controlprogram/mk312-bt/bluetooth_conf/HC05PINOUT.png

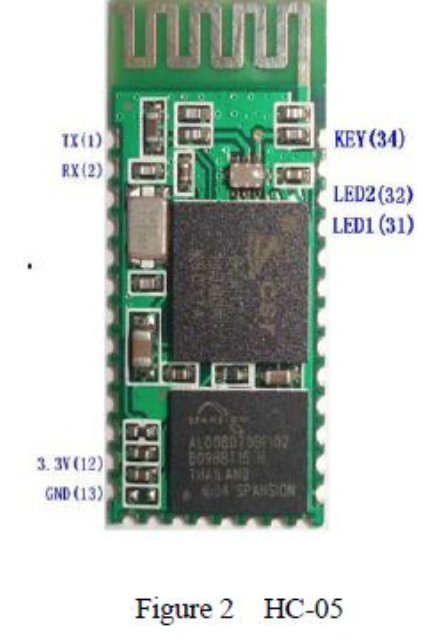
bluetooth_conf/HC05PINOUT.png
