controlprogram/mk312-bt/images/V1.2/6.JPG

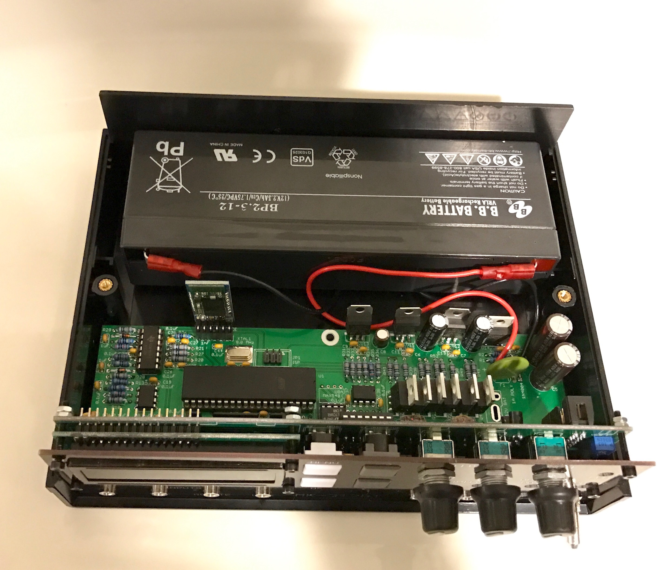
images/V1.2/6.JPG
