controlprogram/mk312-bt/README.md

MK-312BT V1.2

Documentation at : http://tinyurl.com/mk312bt-info
