controlprogram/mk312-bt/images/V1.2/1.JPG

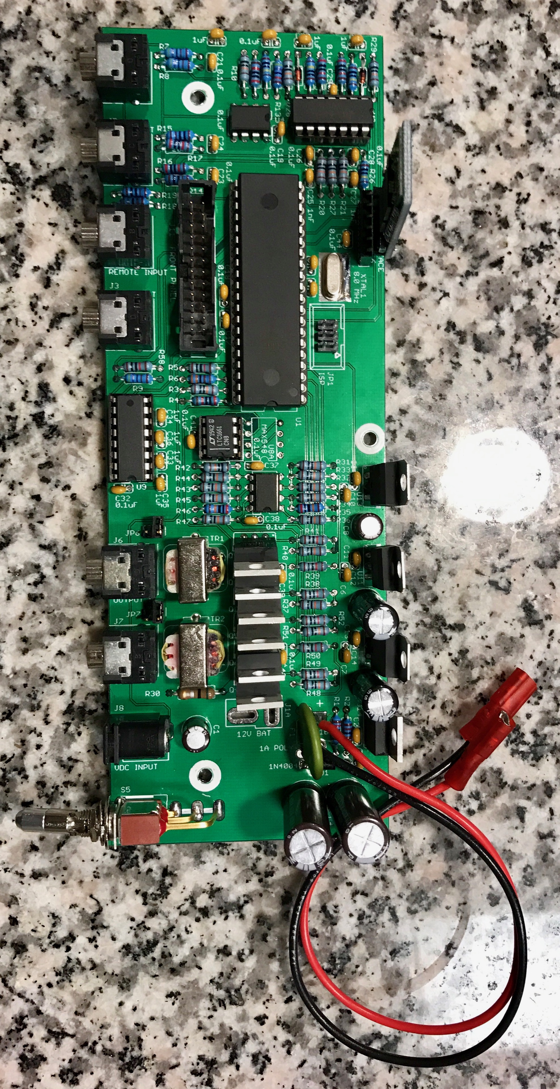
images/V1.2/1.JPG
