controlprogram/mk312-bt/images/V1.2/2.JPG

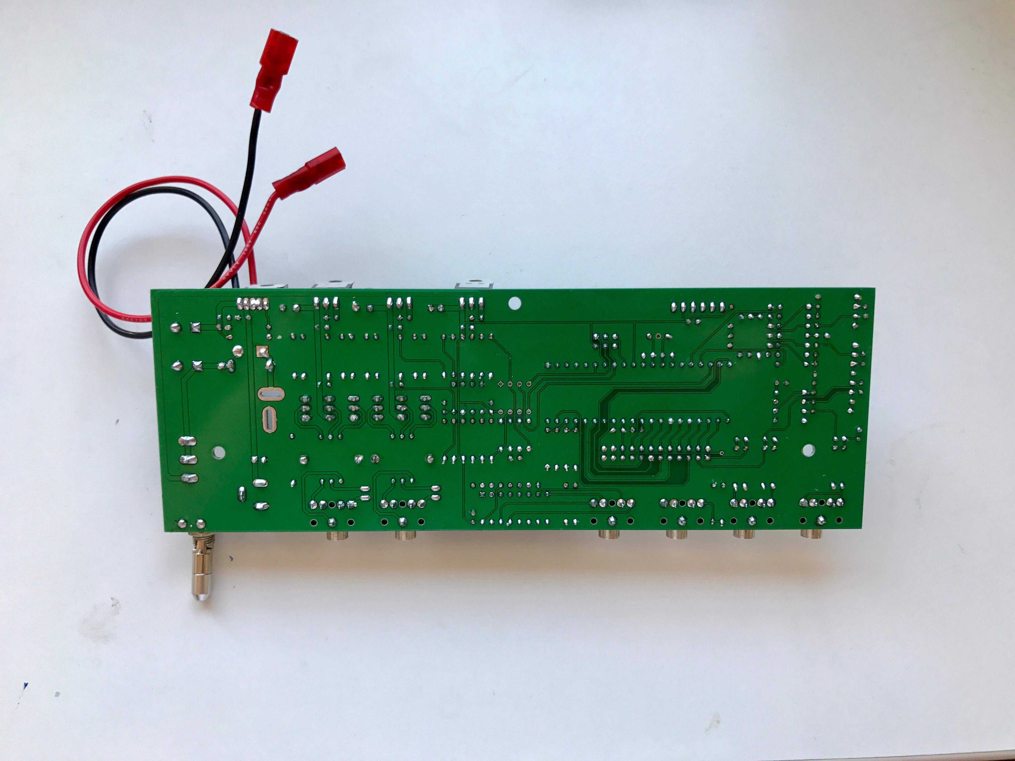
images/V1.2/2.JPG
