controlprogram/mk312-bt/images/V1.2/3.JPG

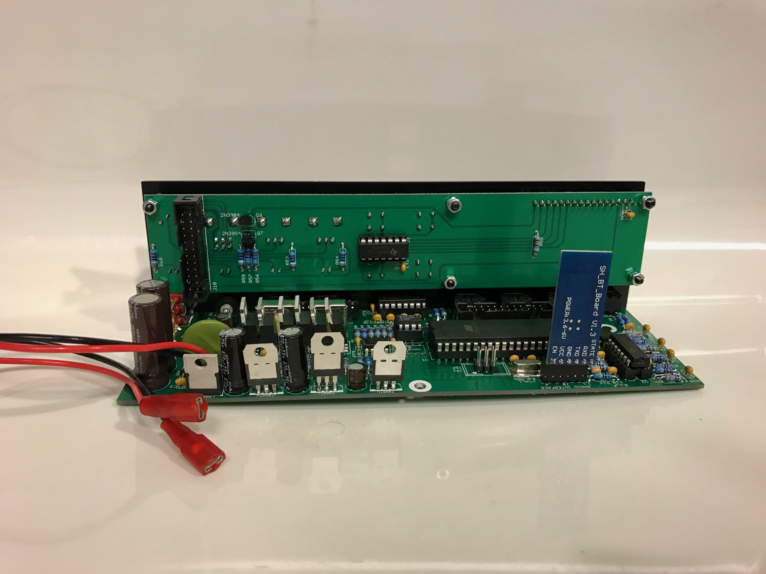
images/V1.2/3.JPG
