controlprogram/mk312-bt/images/V1.2/4.JPG

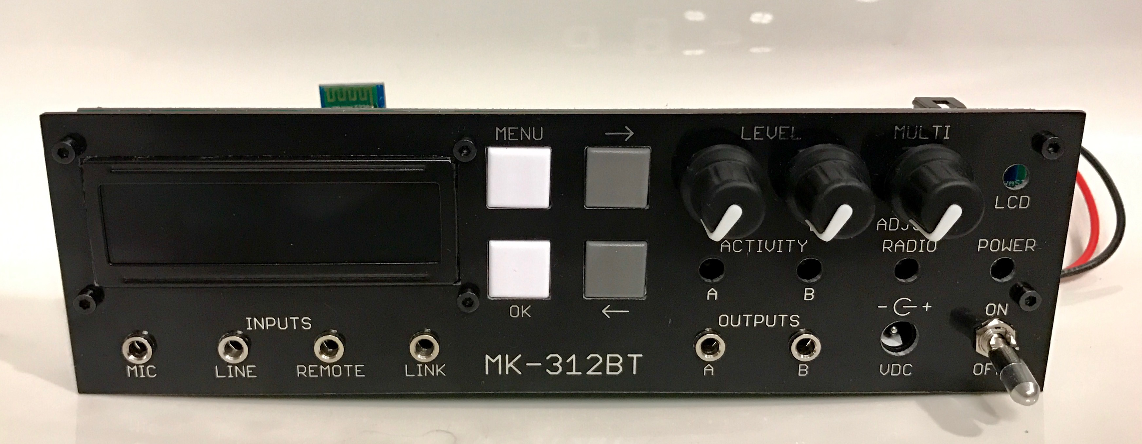
images/V1.2/4.JPG
