controlprogram/mk312-bt/images/V1.2/5.JPG

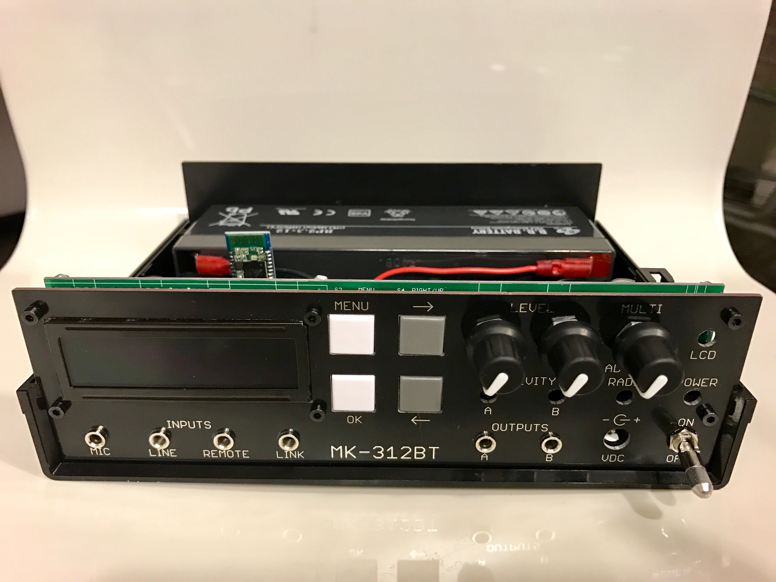
images/V1.2/5.JPG
