controlprogram/mk312-bt/images/V1.2/7.JPG

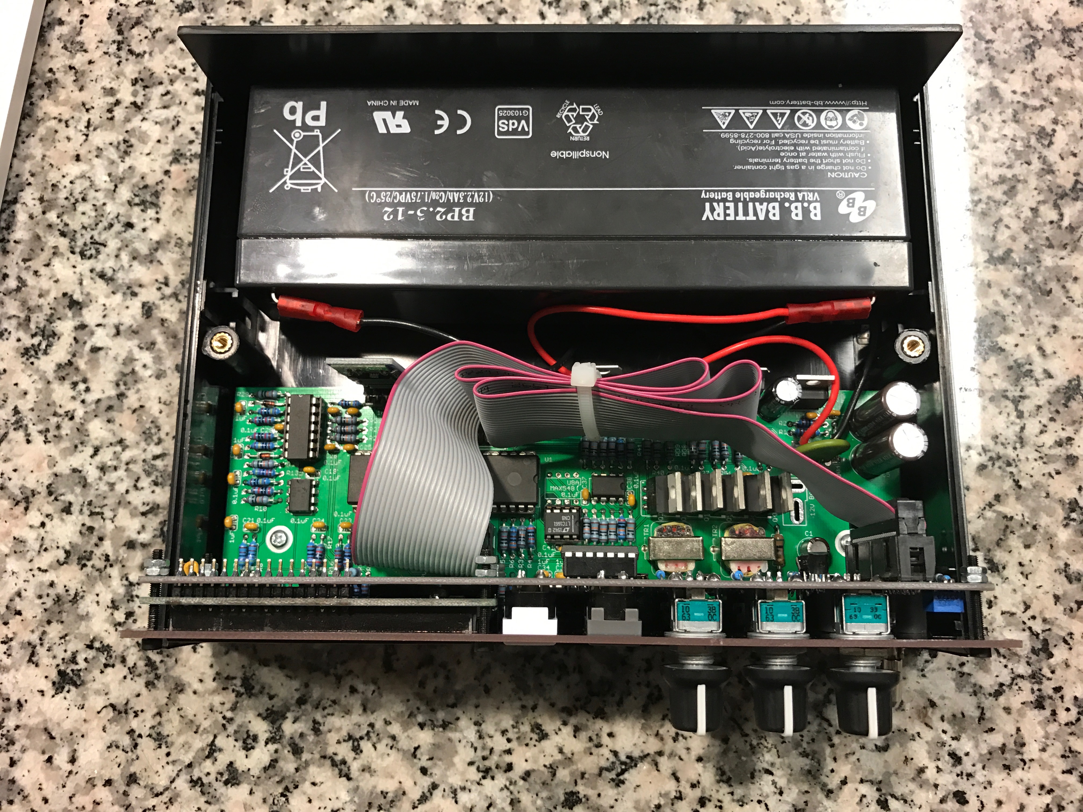
images/V1.2/7.JPG
