controlprogram/mk312-bt/images/V1.2/9.JPG

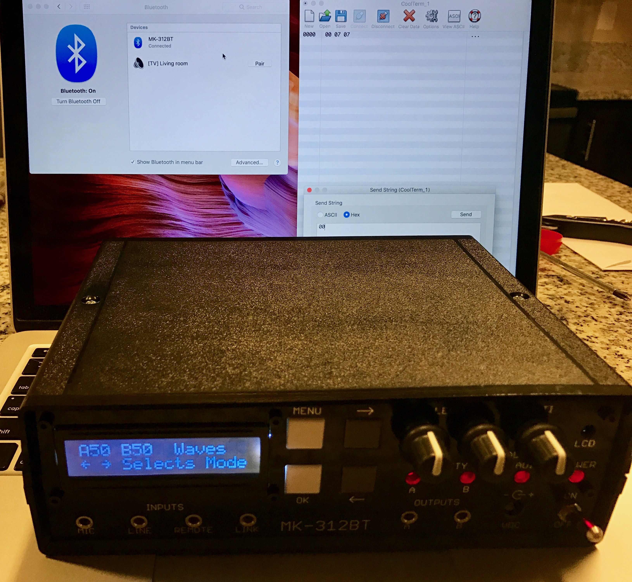
images/V1.2/9.JPG
