controlprogram/mk312-bt/bom_and_readme/MK-312BT.ods

Sheet: INFO
MK-312 BT V1.2 Information
Github Project Home : https://git.io/vMPVF
About
INFO is this Google Sheet - the latest copy of this document lives at http://tinyurl.com/mk312bt-info or https://goo.gl/Ia0wMW
FULLBOM consists of all items - sorted for sanity. Enter the number of units you want to produce in the top row and it will math for you.
MOUSERBOM1 contains items in FULL_BOM available from mouser and we select the "recommended" options . This BOM is for 1 UNIT.
NONMOUSER is a list of all the parts you cant get from Mouser with links to where you can get them from
RAWBOM is the output Eagle generates for the V1.1 schematic. This is used for cross checking the other documents.
MK-312BT V1.2 - How to Order Parts
1) Order the PCB on the Metafetish Slack
2) Order 1 set of the Mouser Parts from this Mouser Project: http://tinyurl.com/mm63csz
3) Order 1 set of Digikey Parts from this Digikey cart (DAC, Ribbon Cable) : http://tinyurl.com/keck3nj
4) Order the case from Allied Electronics : http://tinyurl.com/m8vhmxb
5) Order the hardware parts from McMaster (Wire, Heat Shrink Tubing, sheet metal screw, socket head screw and m2.5 nut (see NONMOUSER sheet tab of this document)
6) (Optionally) order the bluetooth radio from Amazon : http://amzn.to/2l0UEoj
7) If parts on Digikey OR Mouser are showing as "Out of Stock/Backordered - consult FULLBOM and MOUSERBOM1 sheet tabs of this document for replacement parts"
8) (Optional) You will need strong double sided tape to mount the battery - 3M VHB is recommended - http://amzn.to/2nTkawE
MK-312BT V1.2 - Hardware Improvements over original ET-312B
1) Line input modified for matched frequency and level response on left and right channels.
2) Link I/O circuitry replaced with MAX-232CPE For better compatibility (True RS-232 Levels)
3) Provisions for Bluetooth radio, Radio takes over Link I/O when nothing is in the jack
4) New one piece front panel design where LCD, buttons, potentiometers, and LEDs are on the sub panel. Jacks and power switch on mainboard. Cleaner looking design with controls and jacks on 3/4" centers
5) Remote input added to facilitate DC response into B channel without compromising line audio input characteristics. Tip is voltage coming from remote 0-2 volts, Ring supplies 2 volts from a resistor divider internal to the unit. Sleeve is ground. The Remote is meant for the Audio 1 & 2 modes. External potentiometer and push button recommended for remote. Other SPST type of items can be used such as motion detectors with dry contact output or mercury switches.
6) Support for tri polar (+, GND, -) toys on the output channels
MK-312BT Hardware Jumper Settings
1) JP6 and JP7 [DISABLED BY DEFAULT]
Enabling JP6 and JP7 allow the use of tripolar (+, GND, -) toys on the corresponding channels by connecting the center tap of the transformer to the stereo jack
WARNING : ENABLING JP6 and JP7 will cause mono plug toys to short the transformer !!
MK-312BT Hardware Assembly Notes / Tips - PLEASE READ -
1) Trim Potentiometer knobs to correct length if desired
2) Use black permanent marker to black out front panel hole walls if desired
3) Cut the tabs off of the base of the pots so the board sits flush with the display facade if desired
4) To correctly fit LCD - solder header to LCD board first. Next insert LCD panel into front panel daughter board. Then put screws on front panel facade and finger tighten M2.5 screws first. Adjust positions as needed so everything lines up and sits well. Finally solder LCD header to front panel daughter board.
5) Make sure Pin 32 (LED2) on the HC-05 module is actually soldered and making connection to the ZS-040 break out board or "Radio" LED may not function on the front panel
6) Be very careful not to bridge pins when soldering the LM 2941 (U14). Apply heat to 1 pad only and carefully apply solder. If a bridge occurs - remove the IC, clean the pads throughly with flux and solder wick and then retry. Pins 2 and 3 can be bridged because they are both ground. Ensure that no other pins are bridged. Check with multimeter continuity tester for bridges before power on!
8) Make sure to check the orientation of all electrolytic caps. (+) indicates the positive and a solid white "|" indicates the negative .
9) MAKE SURE YOUR POWER PLUG IS CENTER POSITIVE OR THINGS WILL GO BADLY. If you fuck up and plug in a reversed polarity supply - replace electrolytic caps C1 and C4.
10) Please remember to adjust the LCD contrast potentiometer - if incorrectly set the unit and backlight will power on but the interface will not be displayed.
11) Place transformers with P facing the output jacks (yes we are using the transformers "backwards" if you follow orientation given in the transformer datasheet )
12)Trim pins of 4066 IC (U3) Socket on the front panel board flush before soldering so buttons can clear. If the buttons still interfere, carefully disassemble the button and cut off the bit of the plastic housing that interferes with the 4066 IC socket pins.
13) Using side cutters cut off the screw boss/screw mount on the case that touches/interferes with the ribbon cable socket on the display board.
14) The LCD display has metal retention tabs that may short the soldered leads of C43. When installing the display board ensure that this does not happen (shorten the capacitor leads and bend the offending metal tab out of the way if necessary. Optionally - Do Not Fit C43 - it is not entirely necessary.
Changes made in buttshock-et312-frankenbutt f005 over original ET 312B V1.5/V1.6 firmware https://git.io/vMoHG
F005 Patches the following in addition to the stock firmware
1) changeversion: changes startup message from v1.6 to f005
2) unifyboxes: allow 1.5 and 1.6 boxes to share the same firmware
3) removerandomxor: box will always pick 0 as it's xor communication key
4) serialdumpmemory: box will allow serial to dump more of the flash memory on request
5) fixknobscaling: A and B levels now display smoothly 0-99 with no missing numbers
6) newmenu; adds a new sub menu "More Options", moves Link Slave to that menu
7) hookmain: adds a new mode "Random 3" kind of a combination of torment and random1 to the new options menu, adds a new mode "Random 4" which turns on with a random mode for 40ish seconds, then off for 20ish seconds
Modifying and Flashing Firmware onto MK312-BT
1) We are using an external 8mhz crystal instead of the internal RC oscillator that the original uses. We need to set the fuses to enable this. LOW FUSE : 0xFF HIGH FUSE : 0xDC
2) A patched version of buttshock-et312-frankenbutt-f005 is recommended .
3) The firmware needs to be changed to replace the up/down arrows on the UI with left right arrows (this is because the LCD we use has a different character set)
4) Obtain or modify a copy of the firmware and flash the result onto the AVR.
5) If you dont want to use an external crystal - we need to set the calibration byte for the internal oscillator. If programming a blank chip you first need to read the calibration bytes of that part (i.e. using avrdude -t “dump calibration” the fourth byte is the calibration byte for 8MHz or use atmel studio to read the oscillator calibration byte). Then program that byte into 0x3fff in your firmware. These bytes will differ on different chips even from the same batch. The firmware reads that byte to set OSCCAL on startup. If the byte is inaccurate various problems and failures will occur related to timing, interrupts, and serial communication. Just use an external crystal dammit.
6) In order to reduce display flicker on MK312-BT go to offset 0x45E and change it from 0xAE 0x70 to 0xAF 0x73
Errata and and Changes made from V1.0 to V1.1
1) C25 and C27 are mislabeled on the board, 1000pF is the correct value (FIXED)
2) R20 and R21 are mislabeled on the board, 100K is the correct value (FIXED)
3) R14 and R15 are mislabeled on the board, 1K is the correct value (FIXED)
4) R20 and R21 are mislabeled on the board, 20K is the correct value (FIXED)
5) Do not populate R9 100K (FIXED)
6) Do not populate R1B 12K (FIXED)
Errata and and Changes made from V1.1 to V1.2
1) Fixed routing error on display board. (FIXED)
2) Removed JP3 because pointless. (FIXED)
3) Changed size of electrolytics to make things fit a bit nicer. (FIXED)
Images of V1.2 MK 312BT
TODO : Changes to make for V1.3 MK 312BT
1) LM 2941 footprint to make it easier to solder without bridging
2) Move 4066 IC to better place. (DONE)
3) Fix silkscreen "+" on electrolytic caps C4 C5 (DONE)
4) Move ribbon cable socket slightly lower so it doesnt foul on the case screw boss
5) Move C43 lower to remove chance of shorting with display retention tabs or remove C43 altogether (SOLUTION : DNF C43)
6) Make pads and pad/track juntions bigger for easier rework

Sheet: FULLBOM
Number of Units Produced : | 1
Designator | Description | Quantity per Unit | Total Quantity | Supplier | Supplier Part Number | Alternate Part | Notes
R55 | RES 47R | 1 | 1 | Mouser | 660-MF1/4DC47R0F
R53,R54,R59,R60 | RES 390R | 4 | 4 | Mouser | 660-MF1/4DCT52R3900F
C10,C11,C12,C13,C14,C17,C18,C19,C2,C21,C22,C23,C24,C26,C28,C29,C3,C32,C37,C38,C39,C40,C41,C42,C43,C44,C9 | CAP 0.1uF (0.1" spacing) 50V | 27 | 27 | Mouser | 80-C320C104K5R
R30 | RES 0.5R 1/2W | 1 | 1 | Mouser | 660-CF1/2CT52RR50J
R2 | RES 1.2K | 1 | 1 | Mouser | 660-MF1/4DCT52R1201F
R18, R56,R57 | RES 1.5K | 3 | 3 | Mouser | 660-MF1/4DCT52R1501F
C4,C5 | 1000uF 16V minimum | 2 | 2 | Mouser | 647-UPW1E102MPD6
R10,R20,R21,R27,R28,R29,R3,R31,R32,R33,R34,R36,R37,R40,R42,R43,R44,R45,R47,R48,R51 | RES 100K | 21 | 21 | Mouser | 660-MF1/4DC1003F
R38,R39,R41,R49,R5,R50,R52,R58 | RES 10K | 8 | 8 | Mouser | 660-MF1/4DCT52R1002F | 660-MF1/4DC1002F
C8 | CAP 10uF | 1 | 1 | Mouser | 647-USV1H100MFD1TP
C1 | CAP 10uF CER | 1 | 1 | Mouser | 810-FG11X7R1H106KRT6 |  | Ceramic Cap in case of reverse voltage dc supply
R1A | RES 12K | 1 | 1 | Mouser | 660-MF1/4DCT52R1202F
C15,C16 | CAP 18pF | 2 | 2 | Mouser | 80-C315C180J1G
F1 | 1A POLYFUSE | 1 | 1 | Mouser | 650-LVR100S
R14,R15,R19, | RES 1K | 3 | 3 | Mouser | 660-MF1/4DCT52R1001F
R12,R23,R25,R26 | RES 1M | 4 | 4 | Mouser | 660-MF1/4DCT52R1004F
D1 | DIODE 1N4004 | 1 | 1 | Mouser | 621-1N4004
D2,D3 | DIODE 1N4148 | 2 | 2 | Mouser | 512-1N4148
C25,C27 | CAP 1nF (0.1" spacing) | 2 | 2 | Mouser | 80-C315C102K1G
C20,C30,C31,C33,C34,C35,C36 | CAP 1uF (0.1" spacing) | 7 | 7 | Mouser | 80-C315C105K3R
R35,R46 | RES 200K | 2 | 2 | Mouser | 660-MF1/4DCT52R2003F
R11,R16,R17,R22,R24,R4 | RES 20K | 6 | 6 | Mouser | 660-MF1/4DCT52R2002F
J10,J11 | PAK100/2500-24 - 2425- 3M WALL HEADER | 2 | 2 | Mouser | 517-N2524-6002RB
Q7,Q8 | TRANS. 2N3904 | 2 | 2 | Mouser | 512-2N3904BU
R6 | RES 3.3K | 1 | 1 | Mouser | 660-MF1/4DCT52R3301F
R7,R8,R9 | RES 4.7K | 3 | 3 | Mouser | 660-MF1/4DCT52R4701F
U3 | CD4066N | 1 | 1 | Mouser | 595-CD4066BE
TR1,TR2 | 42TL004 | 2 | 2 | Mouser | 42TL004-RC
C6,C7 | CAP 470uF 16V | 2 | 2 | Mouser | 647-UHE1E471MPD
R13 | RES 47K | 1 | 1 | Mouser | 660-MF1/4DCT52R4702F
U13 | VREG 7805T | 1 | 1 | Mouser | 511-L7805ACP | 511-L7805CV
U11,U12 | VREG 7809TV | 2 | 2 | Mouser | 511-L7809CV
XTAL1 | 8MHZ XTAL HC-49S | 1 | 1 | Mouser | 717-9B-8.000MEEJ-B
U1 | ATMEGA 16P | 1 | 1 | Mouser | 556-ATMEGA16A-PU | http://www.digikey.com/short/3fb4z5
LCD1 | LCD HD44780LCD-1602 | 1 | 1 | Mouser | 763-0216K1Z-NSW-BBW | 763-0216K1Z-NSW-FBW
Q3,Q6 | MOSFET IRF9Z24 | 2 | 2 | Mouser | 942-IRF9Z24NPBF
Q1,Q2,Q4,Q5 | MOSFET IRL520N | 4 | 4 | Mouser | 942-IRL520NPBF
JP1 | ISP 6 PIN | 1 | 1 | Mouser | 571-5-146254-3
U14 | LM2941 | 1 | 1 | Mouser | 926-LM2941CT/NOPB
U2 | LM324N | 1 | 1 | Mouser | 595-LM324N | 595-LM324NE3
U10,U4 | LM358N | 2 | 2 | Mouser | 512-LM358N | 926-LM358N/NOPB
U8A (OPTIONAL - RECOMMEND USING U8B INSTEAD) | MAX548 | 0 | 0 | Mouser | 700-MAX548ACPA |  | For V1.5 and below firmware.We suggest using U8B LTC1661 purchased from Digikey (see below)
LED1,LED2,LED3,LED4 | 5MM LED | 4 | 4 | Mouser | 606-4304H1
U9 | MAX232 | 1 | 1 | Mouser | 700-MAX232CPE
SOCKET FOR U2,U3 | DIL 14 IC SOCKET | 2 | 2 | Mouser | 517-4814-3004-CP
SOCKET FOR U9 | DIL 16 IC SOCKET | 1 | 1 | Mouser | 517-4816-3004-CP
SOCKET FOR U1 | DIL 40 IC SOCKET | 1 | 1 | Mouser | 575-11041640410010
SOCKET FOR U10,U4,U8(A/B) | DIL 8 IC SOCKET | 4 | 4 | Mouser | 571-1-2199298-2
JP6,JP7 | 2x1 SIP HEADER 0.1" | 2 | 2 | Mouser | 571-5-146285-2
JUMPER | 0.1" JUMPER | 3 | 3 | Mouser | 571-382811-6
VR1, VR2 | ALPS 9mm 10K Pot | 2 | 2 | Mouser | 688-RK09L1140A2U
VR3 | ALPS 9mm 10K Dual Gang Pot | 1 | 1 | Mouser | 688-RK09L1240A12
VR4 | Bourns 3362P 10K Pot | 1 | 1 | Mouser | 3362P-1-103LF
S1,S2,S3,S4 | Buttons | 4 | 4 | Mouser | 611-D6C90F2LFS
J2,J3,J4,J5,J6,J7 | 3.5mm stereo jack | 6 | 6 | Mouser | 806-STX-3100-5NB
J8 | 2.1/5.5mm DC jack | 1 | 1 | Mouser | 490-PJ-002A
S5 | Toggle Switch with safety actuator | 1 | 1 | Mouser | 611-7101K2AV2BE | 611-7101K2AV2QE
J9 | Radio Header | 1 | 1 | Mouser | 538-90147-1206
PACTEC Case | Case | 1 | 1 | Mouser | 616-63025-510-000 | Suggest buying directly from PACTEC or sourcing a compatible case elsewhere http://bit.ly/2iuAHbB . UK SOURCE : http://uk.rs-online.com/web/p/consoles-desktop-enclosures/1047312/
Gray button covers | Button Cover | 2 | 2 | Mouser | 611-BTND610F | 611-BTND690F
White button covers | Button Cover | 2 | 2 | Mouser | 611-BTND600F
LCD HEADER | LCD Header | 1 | 1 | Mouser | 710-61301611121
KNOB | Potentiometer KNOB | 3 | 3 | Mouser | 450-BA761
BAT1 (Recommended Option) | Lead Acid Battery 2.5AH | 1 | 1 | Mouser | 547-PS-1220 | UK SOURCE http://uk.rs-online.com/web/p/lead-acid-rechargeable-batteries/5375444/
BAT1 (Option) | Lead Acid Battery 1.4AH | 0 | 0 | Mouser | 547-PS-1212
BAT 1 LUGS | Lugs For Connecting to BAT1 | 2 | 2 | Mouser | 534-8291 |  | Crimp on Lugs for Battery
Power Supply 15V (Recommended Option) | 15V, > 1A , 5.5MM OD Plug | 1 | 1 | Mouser | 709-GE24I15-P1J
Power Supply AC Plug | Set of Universal AC Plugs for power supply | 1 | 1 | Mouser | 709-ACPLUG-MIX
Power Supply 18 V | 18V, 1A , 5.5MM OD Plug | 0 | 0 | Mouser | 709-GST18U18-P1J |  | Use 18V version to give linear regulator a bit more headroom . 15V will work fine though
IDC connectors for ribbon cable | Ribbon Cable Connector(or buy a ready made cable) | 2 | 2 | Mouser | 517-8924 |  | Suggest sourcing a ready made cable . See misc hardware below
24 conductor ribbon cable | Bare Ribbon Cable (or buy a ready made cable) | 1 | 1 | Mouser | 517-3365/24-100 |  | See above.
Radio | HC-05 Bluetooth Module | 1 | 1 | Amazon | HC-05 (multiple amazon vendors) |  | http://amzn.to/2iiOXz6
U8B | LTC1661 (For V1.6 and above firmware) | 1 | 1 | Digikey | LTC1661CN8#PBF-ND |  | This is the suggested DAC
J1 T Connector (Deans Connector)- DNF (Unless you want to , then F away) | 12V Battery Connector | 1 | 1 | Hobbyking | SKU: 015000231-0 |  | http://bit.ly/2jpP4gQ
MISC HARDWARE
Ribbon Cable 24 pin, 2.54mm pitch IDC. | Ribbon Cable | 1 | 1 | Amazon | B01BGNLPX0 |  | http://amzn.to/2jp34ay
#4 x 1/4" sheet metal screw (Main board to case) | Screw | 2 | 2 | McMaster-Carr | 90190A106 |  | http://bit.ly/2jCJuVR
M2.5 x 20mm socket head screw (Front panel screws) | Screw | 6 | 6 | McMaster-Carr | 91290A108 |  | http://bit.ly/2jhEohH
M2.5 nut (Front panel nut) | Screw | 22 | 22 | McMaster-Carr | 90591A270 |  | http://bit.ly/2jpf0Jq
18 Gauge Wire : | Battery Leads (quantity ft) | 5 | 5 | McMaster-Carr | 8054T15 |  | http://bit.ly/2jCHwER
Heat Shrink | Heat Shrink Tubing | 1 | 1 | McMaster-Carr | 7496K43 |  | http://bit.ly/2jYteSl

Sheet: MOUSERBOM1
Designator | Description | Quantity per Unit | Supplier | Supplier Part Number | Mfg Part Number | Alternate Part
R55 | RES 47R | 1 | Mouser | 660-MF1/4DC47R0F | MF1/4DC47R0F
R53,R54,R59,R60 | RES 390R | 4 | Mouser | 660-MF1/4DCT52R3900F | MF1/4DCT52R3900F
C10,C11,C12,C13,C14,C17,C18,C19,C2,C21,C22,C23,C24,C26,C28,C29,C3,C32,C37,C38,C39,C40,C41,C42,C43,C44,C9 | CAP 0.1uF (0.1" spacing) 50V | 27 | Mouser | 80-C320C104K5R | C320C104K5R5TA
R30 | RES 0.5R 1/2W | 1 | Mouser | 660-CF1/2CT52RR50J | CF1/2CT52RR50J
R2 | RES 1.2K | 1 | Mouser | 660-MF1/4DCT52R1201F | MF1/4DCT52R1201F
R18, R56,R57 | RES 1.5K | 3 | Mouser | 660-MF1/4DCT52R1501F | MF1/4DCT52R1501F
C4,C5 | 1000uF 16V minimum | 2 | Mouser | 647-UPW1E102MPD6 | UPW1E102MPD6
R10,R20,R21,R27,R28,R29,R3,R31,R32,R33,R34,R36,R37,R40,R42,R43,R44,R45,R47,R48,R51 | RES 100K | 21 | Mouser | 660-MF1/4DC1003F | MF1/4DC1003F
R38,R39,R41,R49,R5,R50,R52,R58 | RES 10K | 8 | Mouser | 660-MF1/4DC1002F | MF1/4DC1002F | 660-MF1/4DCT52R1002F
C8 | CAP 10uF | 1 | Mouser | 647-USV1H100MFD1TP | USV1H100MFD1TP
C1 | CAP 10uF CER | 1 | Mouser | 810-FG11X7R1H106KRT6 | FG11X7R1H106KRT06
R1A | RES 12K | 1 | Mouser | 660-MF1/4DCT52R1202F | MF1/4DCT52R1202F
C15,C16 | CAP 18pF | 2 | Mouser | 80-C315C180J1G | C315C180J1G5TA
F1 | 1A POLYFUSE | 1 | Mouser | 650-LVR100S | LVR100S
R14,R15,R19, | RES 1K | 3 | Mouser | 660-MF1/4DCT52R1001F | MF1/4DCT52R1001F
R12,R23,R25,R26 | RES 1M | 4 | Mouser | 660-MF1/4DCT52R1004F | MF1/4DCT52R1004F
D1 | DIODE 1N4004 | 1 | Mouser | 621-1N4004 | 1N4004-T
D2,D3 | DIODE 1N4148 | 2 | Mouser | 512-1N4148 | 1N4148
C25,C27 | CAP 1nF (0.1" spacing) | 2 | Mouser | 80-C315C102K1G | C315C102K1G5TA
C20,C30,C31,C33,C34,C35,C36 | CAP 1uF (0.1" spacing) | 7 | Mouser | 80-C315C105K3R | C315C105K3R5TA
R35,R46 | RES 200K | 2 | Mouser | 660-MF1/4DCT52R2003F | MF1/4DCT52R2003F
R11,R16,R17,R22,R24,R4 | RES 20K | 6 | Mouser | 660-MF1/4DCT52R2002F | MF1/4DCT52R2002F
J10,J11 | PAK100/2500-24 - 2425- 3M WALL HEADER | 2 | Mouser | 517-N2524-6002RB | N2524-6002RB
Q7,Q8 | TRANS. 2N3904 | 2 | Mouser | 512-2N3904BU | 2N3904BU
R6 | RES 3.3K | 1 | Mouser | 660-MF1/4DCT52R3301F | MF1/4DCT52R3301F
R7,R8,R9 | RES 4.7K | 3 | Mouser | 660-MF1/4DCT52R4701F | MF1/4DCT52R4701F
U3 | CD4066N | 1 | Mouser | 595-CD4066BE | CD4066BE
TR1,TR2 | 42TL004 | 2 | Mouser | 42TL004-RC | 42TL004-RC
C6,C7 | CAP 470uF 16V | 2 | Mouser | 647-UHE1E471MPD | UHE1E471MPD
R13 | RES 47K | 1 | Mouser | 660-MF1/4DCT52R4702F | MF1/4DCT52R4702F
U13 | VREG 7805T | 1 | Mouser | 511-L7805ACP | L7805ACP | 511-L7805CV
U11,U12 | VREG 7809TV | 2 | Mouser | 511-L7809CV | L7809CV
XTAL1 | 8MHZ XTAL HC-49S | 1 | Mouser | 717-9B-8.000MEEJ-B | 9B-8.000MEEJ-B
U1 | ATMEGA 16P | 1 | Mouser | 556-ATMEGA16A-PU | ATMEGA16A-PU | 556-ATMEGA16L-8PU ELSE SEE DIGIKEY ON NONMOUSER
LCD1 | LCD HD44780LCD-1602 | 1 | Mouser | 763-0216K1Z-NSW-BBW | NHD-0216K1Z-NSW-BBW-L | 763-0216K1Z-NSW-FBW
Q3,Q6 | MOSFET IRF9Z24 | 2 | Mouser | 942-IRF9Z24NPBF | IRF9Z24NPBF
Q1,Q2,Q4,Q5 | MOSFET IRL520N | 4 | Mouser | 942-IRL520NPBF | IRL520NPBF
JP1 | ISP 6 PIN | 1 | Mouser | 571-5-146254-3 | 5-146254-3
U14 | LM2941 | 1 | Mouser | 926-LM2941CT/NOPB | LM2941CT/NOPB
U2 | LM324N | 1 | Mouser | 595-LM324NE3 | LM324NE3 | 595-LM324N
U10,U4 | LM358N | 2 | Mouser | 512-LM358N | LM358N | 926-LM358N/NOPB
U8A | MAX548 (For V1.5 and below firmware) suggest using LTC1661 purchased from Digikey (see end of sheet) | 0 | Mouser | 700-MAX548ACPA | MAX548ACPA+
LED1,LED2,LED3,LED4 | 5MM LED | 4 | Mouser | 606-4304H1 | 4304H1
U9 | MAX232 | 1 | Mouser | 700-MAX232CPE | MAX232CPE
SOCKET FOR U2,U3 | DIL 14 IC SOCKET | 2 | Mouser | 517-4814-3004-CP | 4814-3004-CP
SOCKET FOR U9 | DIL 16 IC SOCKET | 1 | Mouser | 517-4816-3004-CP | 4816-3004-CP
SOCKET FOR U1 | DIL 40 IC SOCKET | 1 | Mouser | 575-11041640410010 | 110-41-640-41-001000
SOCKET FOR U10,U4,U8(A/B) | DIL 8 IC SOCKET | 4 | Mouser | 571-1-2199298-2 | 1-2199298-2
JP6,JP7 | 2x1 SIP HEADER 0.1 | 2 | Mouser | 571-5-146285-2 | 5-146285-2
VR1, VR2 | ALPS 9mm 10K Pot | 2 | Mouser | 688-RK09L1140A2U | RK09L1140A2U
VR3 | ALPS 9mm 10K Dual Gang Pot | 1 | Mouser | 688-RK09L1240A12 | RK09L1240A12
VR4 | Bourns 3362P 10K Pot | 1 | Mouser | 3362P-1-103LF | 3362P-1-103LF
S1,S2,S3,S4 | Buttons | 4 | Mouser | 611-D6C90F2LFS | D6C90 F2 LFS
J2,J3,J4,J5,J6,J7 | 3.5mm stereo jack | 6 | Mouser | 806-STX-3100-5NB | STX-3100-5NB
J8 | 2.1/5.5mm DC jack | 1 | Mouser | 490-PJ-002A | PJ-002A
S5 | Toggle Switch with safety actuator | 1 | Mouser | 611-7101K2AV2BE | 7101K2AV2BE | 611-7101K2AV2QE
J9 | Radio Header | 1 | Mouser | 538-90147-1206 | 90147-1206
Gray button covers | Button Cover | 2 | Mouser | 611-BTND610F | BTND610F | 611-BTND690F
White button covers | Button Cover | 2 | Mouser | 611-BTND600F | BTN D6 00 F
LCD HEADER | LCD Header | 1 | Mouser | 710-61301611121 | 61301611121
Knob | Potentiometer Knob | 3 | Mouser | 450-BA761 | BA761
BAT1 | Lead Acid Battery | 1 | Mouser | 547-PS-1220 | PS-1220
BAT1 Lugs | Crimp Lubs for BAT1 | 2 | Mouser | 534-8291 | 534-8291
Power Supply | 15V, 1.6A .5.5mm OD plug | 1 | Mouser | 709-GE24I15-P1J | GE24I15-P1J | 709-GST25U15-P1J
Power Supply AC Plug | Set of Universal AC Plugs for All Wall Sockets | 1 | Mouser | 709-ACPLUG-MIX | AC Plug-MIX

Sheet: NONMOUSER
Parts Not Sourced from Mouser
Part | Quantity
Bluetooth Radio HC - 05 | 1
Amazon : http://amzn.to/2l0UEoj
3M VHB double sided tape
Amazon : http://amzn.to/2nTkawE
LTC 1661 DAC | 1
Digikey LTC1661CN8#PBF-ND : http://www.digikey.com/short/3rh0zq
LM324N (Digikey if mouser is out of stock)
Digikey : http://www.digikey.com/short/3fb4md | 1
ATMEGA 16 (Digikey if mouser is out of stock)
Digikey : http://www.digikey.com/short/3fb4z5 | 1
Ribbon Cable 24 pin, 2.54mm pitch IDC. | 1
Digikey : http://www.digikey.com/short/32f18w
Amazon : http://amzn.to/2jp34ay
18 Gauge Wire : | 5ft
McMaster-Carr: http://bit.ly/2jCHwER
Heat Shrink Tubing: | 1 pack
McMaster-Carr : http://bit.ly/2jYteSl
#4 x 1/4" sheet metal screw (Main board to case) | 2
McMaster-Carr : http://bit.ly/2jCJuVR
M2.5 x 20mm socket head screw (Front panel screws) | 6
McMaster-Carr : http://bit.ly/2jhEohH
M2.5 nut (Front panel nut) | 22
McMaster-Carr : http://bit.ly/2jpf0Jq
T Connector (Deans Connector - OPTIONAL) | 1
Hobbyking : http://bit.ly/2jpP4gQ
Lead Acid Battery
Digikey : https://www.digikey.com/short/3ff7t4
Pactec Case | 1
Allied : http://www.alliedelec.com/pactec-cm86-225-000-k/70080019/
Pactec : https://www.pactecenclosures.com/product-detail.php?productid=72&classid=26&seriesid=45
UK Souce RS Online : http://uk.rs-online.com/web/p/consoles-desktop-enclosures/1047312/

Sheet: RAWBOM
V1.1 EAGLE BOM OUTPUT
Part | Value | Device | Package | Description
R55 | 47 | R-US_0207/10 | 0207/10 | RESISTOR, American symbol
R53 | 390 | R-US_0207/10 | 0207/10 | RESISTOR, American symbol
R54 | 390 | R-US_0207/10 | 0207/10 | RESISTOR, American symbol
R59 | 390 | R-US_0207/10 | 0207/10 | RESISTOR, American symbol
R60 | 390 | R-US_0207/10 | 0207/10 | RESISTOR, American symbol
J1 | 12V BATTERY | BATTERY_CONNDEANS | DEANS | Various footprints for battery connectors
C10 | 0.1uF | C-US025-024X044 | C025-024X044 | CAPACITOR, American symbol
C11 | 0.1uF | C-US025-024X044 | C025-024X044 | CAPACITOR, American symbol
C12 | 0.1uF | C-US025-024X044 | C025-024X044 | CAPACITOR, American symbol
C13 | 0.1uF | C-US025-024X044 | C025-024X044 | CAPACITOR, American symbol
C14 | 0.1uF | C-US025-024X044 | C025-024X044 | CAPACITOR, American symbol
C17 | 0.1uF | C-US025-024X044 | C025-024X044 | CAPACITOR, American symbol
C18 | 0.1uF | C-US025-024X044 | C025-024X044 | CAPACITOR, American symbol
C19 | 0.1uF | C-US025-024X044 | C025-024X044 | CAPACITOR, American symbol
C2 | 0.1uF | C-US025-024X044 | C025-024X044 | CAPACITOR, American symbol
C21 | 0.1uF | C-US025-024X044 | C025-024X044 | CAPACITOR, American symbol
C22 | 0.1uF | C-US025-024X044 | C025-024X044 | CAPACITOR, American symbol
C23 | 0.1uF | C-US025-024X044 | C025-024X044 | CAPACITOR, American symbol
C24 | 0.1uF | C-US025-024X044 | C025-024X044 | CAPACITOR, American symbol
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
D1 | 1N4004 | 1N4004 | DO41-10 | DIODE
D2 | 1N4148DO35-10 | 1N4148DO35-10 | DO35-10 | DIODE
D3 | 1N4148DO35-10 | 1N4148DO35-10 | DO35-10 | DIODE
C25 | 1nF | C-US025-024X044 | C025-024X044 | CAPACITOR, American symbol
C27 | 1nF | C-US025-024X044 | C025-024X044 | CAPACITOR, American symbol
C20 | 1uF | C-US025-024X044 | C025-024X044 | CAPACITOR, American symbol
C30 | 1uF | C-US025-024X044 | C025-024X044 | CAPACITOR, American symbol
C31 | 1uF | C-US025-024X044 | C025-024X044 | CAPACITOR, American symbol
C33 | 1uF | C-US025-024X044 | C025-024X044 | CAPACITOR, American symbol
C34 | 1uF | C-US025-024X044 | C025-024X044 | CAPACITOR, American symbol
C35 | 1uF | C-US025-024X044 | C025-024X044 | CAPACITOR, American symbol
C36 | 1uF | C-US025-024X044 | C025-024X044 | CAPACITOR, American symbol
R35 | 200K | R-US_0207/10 | 0207/10 | RESISTOR, American symbol
R46 | 200K | R-US_0207/10 | 0207/10 | RESISTOR, American symbol
R11 | 20K | R-US_0207/10 | 0207/10 | RESISTOR, American symbol
R16 | 20K | R-US_0207/10 | 0207/10 | RESISTOR, American symbol
R17 | 20K | R-US_0207/10 | 0207/10 | RESISTOR, American symbol
R22 | 20K | R-US_0207/10 | 0207/10 | RESISTOR, American symbol
R24 | 20K | R-US_0207/10 | 0207/10 | RESISTOR, American symbol
R4 | 20K | R-US_0207/10 | 0207/10 | RESISTOR, American symbol
J10 | 2524- | 2524- | PAK100/2500-24 | 3M (TM) Pak 100 4-Wall Header
Q7 | 2N3904 | 2N3904 | TO92 | NPN TRANSISTOR
Q8 | 2N3904 | 2N3904 | TO92 | NPN TRANSISTOR
R6 | 3.3K | R-US_0207/10 | 0207/10 | RESISTOR, American symbol
R7 | 4.7K | R-US_0207/10 | 0207/10 | RESISTOR, American symbol
R8 | 4.7K | R-US_0207/10 | 0207/10 | RESISTOR, American symbol
R9 | 4.7K | R-US_0207/10 | 0207/10 | RESISTOR, American symbol
U3 | 4066N | 4066N | DIL14 | Quad bilateral ANALOG SWITCH
TR1 | 42TL004 | 42TL023 | 42TL | Xicon Micro-Mini EI-12 Audio Transformers 42TL/42TC/42TM Series
TR2 | 42TL004 | 42TL023 | 42TL | Xicon Micro-Mini EI-12 Audio Transformers 42TL/42TC/42TM Series
C6 | 470uF | CPOL-USE5-10.5 | E3,5-8 | POLARIZED CAPACITOR, American symbol
C7 | 470uF | CPOL-USE5-10.5 | E3,5-8 | POLARIZED CAPACITOR, American symbol
R13 | 47K | R-US_0207/10 | 0207/10 | RESISTOR, American symbol
U13 | 7805T | 7805T | TO220H | Positive VOLTAGE REGULATOR
U11 | 7809TV | 7805T | TO220H | Positive VOLTAGE REGULATOR
U12 | 7809TV | 7805T | TO220H | Positive VOLTAGE REGULATOR
XTAL1 | 8.0 MHz | CRYSTALHC49S | HC49/S | CRYSTAL
U1 | ATMEGA16-P | MEGA16-P | DIL40 | MICROCONTROLLER
J11 | FRONT PANEL | 2524- | PAK100/2500-24 | 3M (TM) Pak 100 4-Wall Header
LCD1 | HD44780LCD-1602 | HD44780LCD-1602 | LCD1602 | HD44780 LCD
Q3 | IRF9Z24 | IRL530N-V | TO220V | MOSFET
Q6 | IRF9Z24 | IRL530N-V | TO220V | MOSFET
Q1 | IRL520N | IRL530N-V | TO220V | MOSFET
Q2 | IRL520N | IRL530N-V | TO220V | MOSFET
Q4 | IRL520N | IRL530N-V | TO220V | MOSFET
Q5 | IRL520N | IRL530N-V | TO220V | MOSFET
JP1 | ISP | 057-006-1 | 057-006-1 | CONNECTOR
VR4 | LCD CONTRAST | TRIM_US-B25P | B25P | POTENTIOMETER
S3 | LEFT/DOWN | DTE6K | DTE6K | ITT SWITCH
VR1 | LEVEL A | 9MM_SNAP-IN_POT_CHASSIS | 9MM_SNAP-IN_POT | 9mm vertical snap-in pot, Alpha / Panasonic style, with a connection to the metal chassis for grounding
VR2 | LEVEL B | 9MM_SNAP-IN_POT_CHASSIS | 9MM_SNAP-IN_POT | 9mm vertical snap-in pot, Alpha / Panasonic style, with a connection to the metal chassis for grounding
J5 | LINE INPUT | STEREOJACK | STX3100 | MIC/HEADPHONE JACK
J3 | LINK INPUT | STEREOJACK | STX3100 | MIC/HEADPHONE JACK
U14 | LM2941 | LM2941 | T05A
U2 | LM324N | LM324N | DIL14 | OP AMP
U10 | LM358N | LM358N | DIL08 | OP AMP also LM158; LM258; LM2904
U4 | LM358N | LM358N | DIL08 | OP AMP also LM158; LM258; LM2904
U8B | LTC1661 | DIL8S | SOCKET-08 | Dual In Line / Socket
U9 | MAX232 | MAX232 | DIL16 | RS232 TRANSCEIVER
U8A | MAX548 | MAX548 | DIL08
S2 | MENU | DTE6K | DTE6K | ITT SWITCH
J4 | MIC INPUT | STEREOJACK | STX3100 | MIC/HEADPHONE JACK
VR3 | MULTI-ADJ | ALPHA-9MM-DUALPOT | DUAL_9MM_SNAP-IN_POT | 9mm vertical snap-in pot, Alpha / Panasonic style, with a connection to the metal chassis for grounding
S1 | OK | DTE6K | DTE6K | ITT SWITCH
J6 | OUTPUT A | STEREOJACK | STX3100 | MIC/HEADPHONE JACK
LED1 | OUTPUT A | LED5MM | LED5MM | LED
J7 | OUTPUT B | STEREOJACK | STX3100 | MIC/HEADPHONE JACK
LED2 | OUTPUT B | LED5MM | LED5MM | LED
LED4 | POWER | LED5MM | LED5MM | LED
S5 | POWER | LPV-1 | LPV-1 | TOGGLE SWITCH
LED3 | RADIO | LED5MM | LED5MM | LED
J9 | RADIO INTERFACE | FE06-1 | FE06 | FEMALE HEADER
J2 | REMOTE INPUT | STEREOJACK | STX3100 | MIC/HEADPHONE JACK
S4 | RIGHT/UP | DTE6K | DTE6K | ITT SWITCH
J8 | VDC INPUT | POWER_JACKSLT | POWER_JACK_SLOT | Power Jack
JP6 |  | JP1E | JP1 | JUMPER
JP7 |  | JP1E | JP1 | JUMPER
V1.2 Eagle BOM OUTPUT GROUPED BY VALUE
Parts | Value | Qty | Device | Package | Description
JP6, JP7 |  | 2 | JP1E | JP1 | JUMPER
J1 | +12V BATTERY | 1 | BATTERY_CONNDEANS | DEANS | Various footprints for battery connectors
C2, C3, C9, C10, C11, C12, C13, C14, C17, C18, C19, C21, C22, C23, C24, C26, C28, C29, C32, C37, C38, C39, C40, C41, C42, C43, C44 | 0.1uF | 27 | C-US025-024X044 | C025-024X044 | CAPACITOR, American symbol
R30 | 0.5R | 1 | R-US_0309/12 | 12/1/0309 | RESISTOR, American symbol
R2 | 1.2K | 1 | R-US_0207/10 | 10/1/0207 | RESISTOR, American symbol
R18, R56, R57 | 1.5K | 3 | R-US_0207/10 | 10/1/0207 | RESISTOR, American symbol
C4, C5 | 1000uF | 2 | CPOL-USE5-10.5 | E5-10,5 | POLARIZED CAPACITOR, American symbol
R3, R10, R20, R21, R27, R28, R29, R31, R32, R33, R34, R36, R37, R40, R42, R43, R44, R45, R47, R48, R51 | 100K | 21 | R-US_0207/10 | 10/1/0207 | RESISTOR, American symbol
R5, R38, R39, R41, R49, R50, R52, R58 | 10K | 8 | R-US_0207/10 | 10/1/0207 | RESISTOR, American symbol
C1, C8 | 10uF | 2 | CPOL-USE2.5-7 | E2,5-7 | POLARIZED CAPACITOR, American symbol
R1 | 12K | 1 | R-US_0207/10 | 10/1/0207 | RESISTOR, American symbol
C15, C16 | 18pF | 2 | C-US025-024X044 | C025-024X044 | CAPACITOR, American symbol
F1 | 1A POLY | 1 | LITTLEFUSE | LITTLEFUSE | LITTLEFUSE
R14, R15, R19 | 1K | 3 | R-US_0207/10 | 10/1/0207 | RESISTOR, American symbol
R12, R23, R25, R26 | 1M | 4 | R-US_0207/10 | 10/1/0207 | RESISTOR, American symbol
D1 | 1N4004 | 1 | 1N4004 | DO41-10 | DIODE
D2, D3 | 1N4148DO35-10 | 2 | 1N4148DO35-10 | DO35-10 | DIODE
C25, C27 | 1nF | 2 | C-US025-024X044 | C025-024X044 | CAPACITOR, American symbol
C20, C30, C31, C33, C34, C35, C36 | 1uF | 7 | C-US025-024X044 | C025-024X044 | CAPACITOR, American symbol
R35, R46 | 200K | 2 | R-US_0207/10 | 10/1/0207 | RESISTOR, American symbol
R4, R11, R16, R17, R22, R24 | 20K | 6 | R-US_0207/10 | 10/1/0207 | RESISTOR, American symbol
J10 | 2524- | 1 | 2524- | PAK100/2500-24 | 3M (TM) Pak 100 4-Wall Header
Q7, Q8 | 2N3904 | 2 | 2N3904 | TO92 | NPN TRANSISTOR
R6 | 3.3K | 1 | R-US_0207/10 | 10/1/0207 | RESISTOR, American symbol
R53, R54, R59, R60 | 390 | 4 | R-US_0207/10 | 10/1/0207 | RESISTOR, American symbol
R7, R8, R9 | 4.7K | 3 | R-US_0207/10 | 10/1/0207 | RESISTOR, American symbol
U3 | 4066N | 1 | 4066N | DIL14 | Quad bilateral ANALOG SWITCH
TR1, TR2 | 42TL004 | 2 | 42TL023 | 42TL | Xicon Micro-Mini EI-12 Audio Transformers 42TL/42TC/42TM Series
R55 | 47 | 1 | R-US_0207/10 | 10/1/0207 | RESISTOR, American symbol
C6, C7 | 470uF | 2 | CPOL-USE3.5-8 | E3,5-8 | POLARIZED CAPACITOR, American symbol
R13 | 47K | 1 | R-US_0207/10 | 10/1/0207 | RESISTOR, American symbol
U13 | 7805TV | 1 | 7805TV | TO220V | Positive VOLTAGE REGULATOR
U11, U12 | 7809TV | 2 | 7805TV | TO220V | Positive VOLTAGE REGULATOR
XTAL1 | 8.0 MHz | 1 | CRYSTALHC49S | HC49/S | CRYSTAL
U1 | ATMEGA16-P | 1 | MEGA16-P | DIL40 | MICROCONTROLLER
J11 | FRONT PANEL | 1 | 2524- | PAK100/2500-24 | 3M (TM) Pak 100 4-Wall Header
LCD1 | HD44780LCD-1602 | 1 | HD44780LCD-1602 | LCD1602 | HD44780 LCD
Q3, Q6 | IRF9Z24 | 2 | IRL530N-V | TO220V | MOSFET
Q1, Q2, Q4, Q5 | IRL520N | 4 | IRL530N-V | TO220V | MOSFET
JP1 | ISP | 1 | 057-006-1 | 057-006-1 | CONNECTOR
VR4 | LCD CONTRAST | 1 | TRIM_US-B25P | B25P | POTENTIOMETER
S3 | LEFT/DOWN | 1 | DTE6K | DTE6K | ITT SWITCH
VR1 | LEVEL A | 1 | 9MM_SNAP-IN_POT_CHASSIS | 9MM_SNAP-IN_POT | 9mm vertical snap-in pot, Alpha / Panasonic style, with a connection to the metal chassis for grounding
VR2 | LEVEL B | 1 | 9MM_SNAP-IN_POT_CHASSIS | 9MM_SNAP-IN_POT | 9mm vertical snap-in pot, Alpha / Panasonic style, with a connection to the metal chassis for grounding
J5 | LINE INPUT | 1 | STEREOJACK | STX3100 | MIC/HEADPHONE JACK
J3 | LINK INPUT | 1 | STEREOJACK | STX3100 | MIC/HEADPHONE JACK
U14 | LM2941K | 1 | LM2941K | TO220-5KC | LDO REGULATOR
U2 | LM324N | 1 | LM324N | DIL14 | OP AMP
U4, U10 | LM358N | 2 | LM358N | DIL08 | OP AMP also LM158; LM258; LM2904
U8B | LTC1661 | 1 | DIL8S | SOCKET-08 | Dual In Line / Socket
U9 | MAX232 | 1 | MAX232 | DIL16 | RS232 TRANSCEIVER
U8A | MAX548 | 1 | MAX548 | DIL08
S2 | MENU | 1 | DTE6K | DTE6K | ITT SWITCH
J4 | MIC INPUT | 1 | STEREOJACK | STX3100 | MIC/HEADPHONE JACK
VR3 | MULTI-ADJ | 1 | ALPHA-9MM-DUALPOT | DUAL_9MM_SNAP-IN_POT | 9mm vertical snap-in pot, Alpha / Panasonic style, with a connection to the metal chassis for grounding
S1 | OK | 1 | DTE6K | DTE6K | ITT SWITCH
LED1 | OUTPUT A | 1 | LED5MM | LED5MM | LED
J6 | OUTPUT A | 1 | STEREOJACK | STX3100 | MIC/HEADPHONE JACK
LED2 | OUTPUT B | 1 | LED5MM | LED5MM | LED
J7 | OUTPUT B | 1 | STEREOJACK | STX3100 | MIC/HEADPHONE JACK
LED4 | POWER | 1 | LED5MM | LED5MM | LED
S5 | POWER | 1 | LPV-1 | LPV-1 | TOGGLE SWITCH
LED3 | RADIO | 1 | LED5MM | LED5MM | LED
J9 | RADIO INTERFACE | 1 | FE06-1 | FE06 | FEMALE HEADER
J2 | REMOTE INPUT | 1 | STEREOJACK | STX3100 | MIC/HEADPHONE JACK
S4 | RIGHT/UP | 1 | DTE6K | DTE6K | ITT SWITCH
J8 | VDC INPUT | 1 | POWER_JACKSLT | POWER_JACK_SLOT | Power Jack
