controlprogram/mk312-bt/eagle_design_files/MK-312BT Main Boards V1.2 Eagle/MK-312BT V1.2.brd

## EAGLE design eagle_design_files/MK-312BT Main Boards V1.2 Eagle/MK-312BT V1.2.brd (2017-02-11)

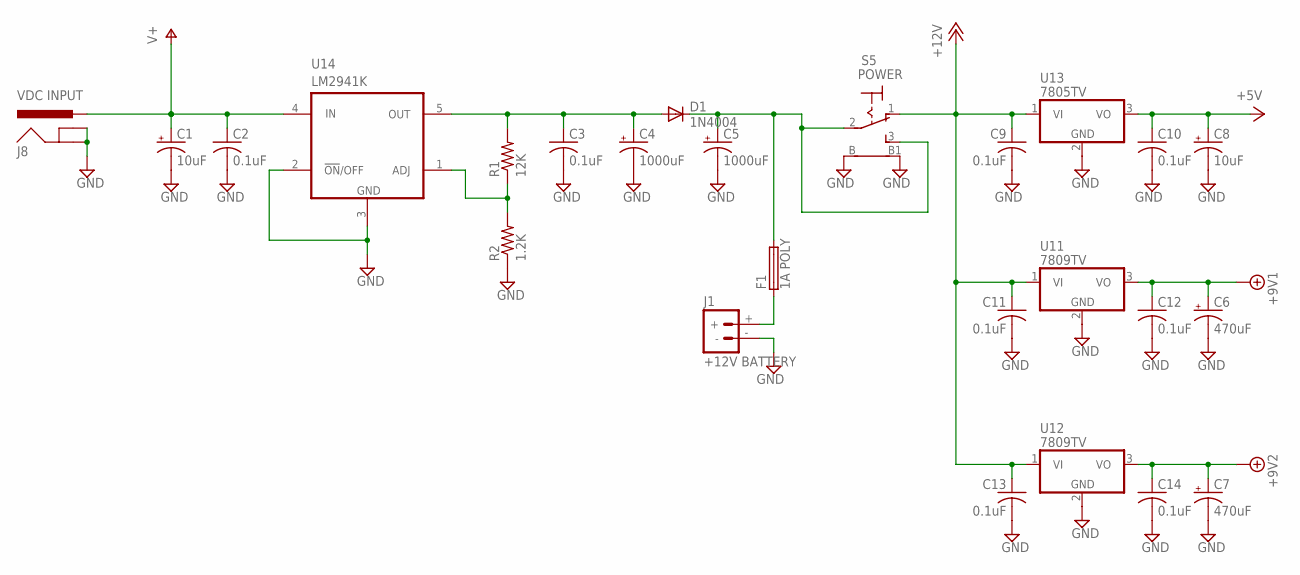
[picture p10: schematic MK-312BT V1.2.sch, sheet 1, PSU]

Parts:
C1, C8: 10uF; E2,5-7
C2, C3, C9, C10, C11, C12, C13, C14: 0.1uF; C025-024X044
C4, C5: 1000uF; E5-10,5
C6, C7: 470uF; E3,5-8
D1: 1N4004; DO41-10
F1: 1A POLY; LITTLEFUSE
J1: +12V BATTERY; DEANS
J8: VDC INPUT; POWER_JACK_SLOT
R1: 12K; 0207/10
R2: 1.2K; 0207/10
S5: POWER; LPV-1
U11, U12: 7809TV; TO220V
U13: 7805TV; TO220V
U14: LM2941K; TO220-5KC

Connections:
+5V: C8.+, C10.1, U13.3 (VO); also elsewhere on the board
+8V: C6.+, C12.1, U11.3 (VO); also elsewhere on the board
+9V: C7.+, C14.1, U12.3 (VO); also elsewhere on the board
+12V: C9.1, C11.1, C13.1, S5.1 (O), U11.1 (VI), U12.1 (VI), U13.1 (VI); also elsewhere on the board
GND: C1.-, C2.2, C3.2, C4.-, C5.-, C6.-, C7.-, C8.-, C9.2, C10.2, C11.2, C12.2, C13.2, C14.2, J1.-, J8.GND@1 (GNDBREAK), J8.GND@2 (GND), R2.1, S5.B, S5.B1, U11.2 (GND), U12.2 (GND), U13.2 (GND), U14.2 (!ON!/OFF), U14.3 (GND); also elsewhere on the board
unnamed: F1.1, J1.+
unnamed: R1.1, R2.2, U14.1 (ADJ)
unnamed: C3.1, C4.+, D1.A, R1.2, U14.5 (OUT)
unnamed: C5.+, D1.C, F1.2, S5.2, S5.3 (S)
V+: C1.+, C2.1, J8.PWR, U14.4 (IN); also elsewhere on the board

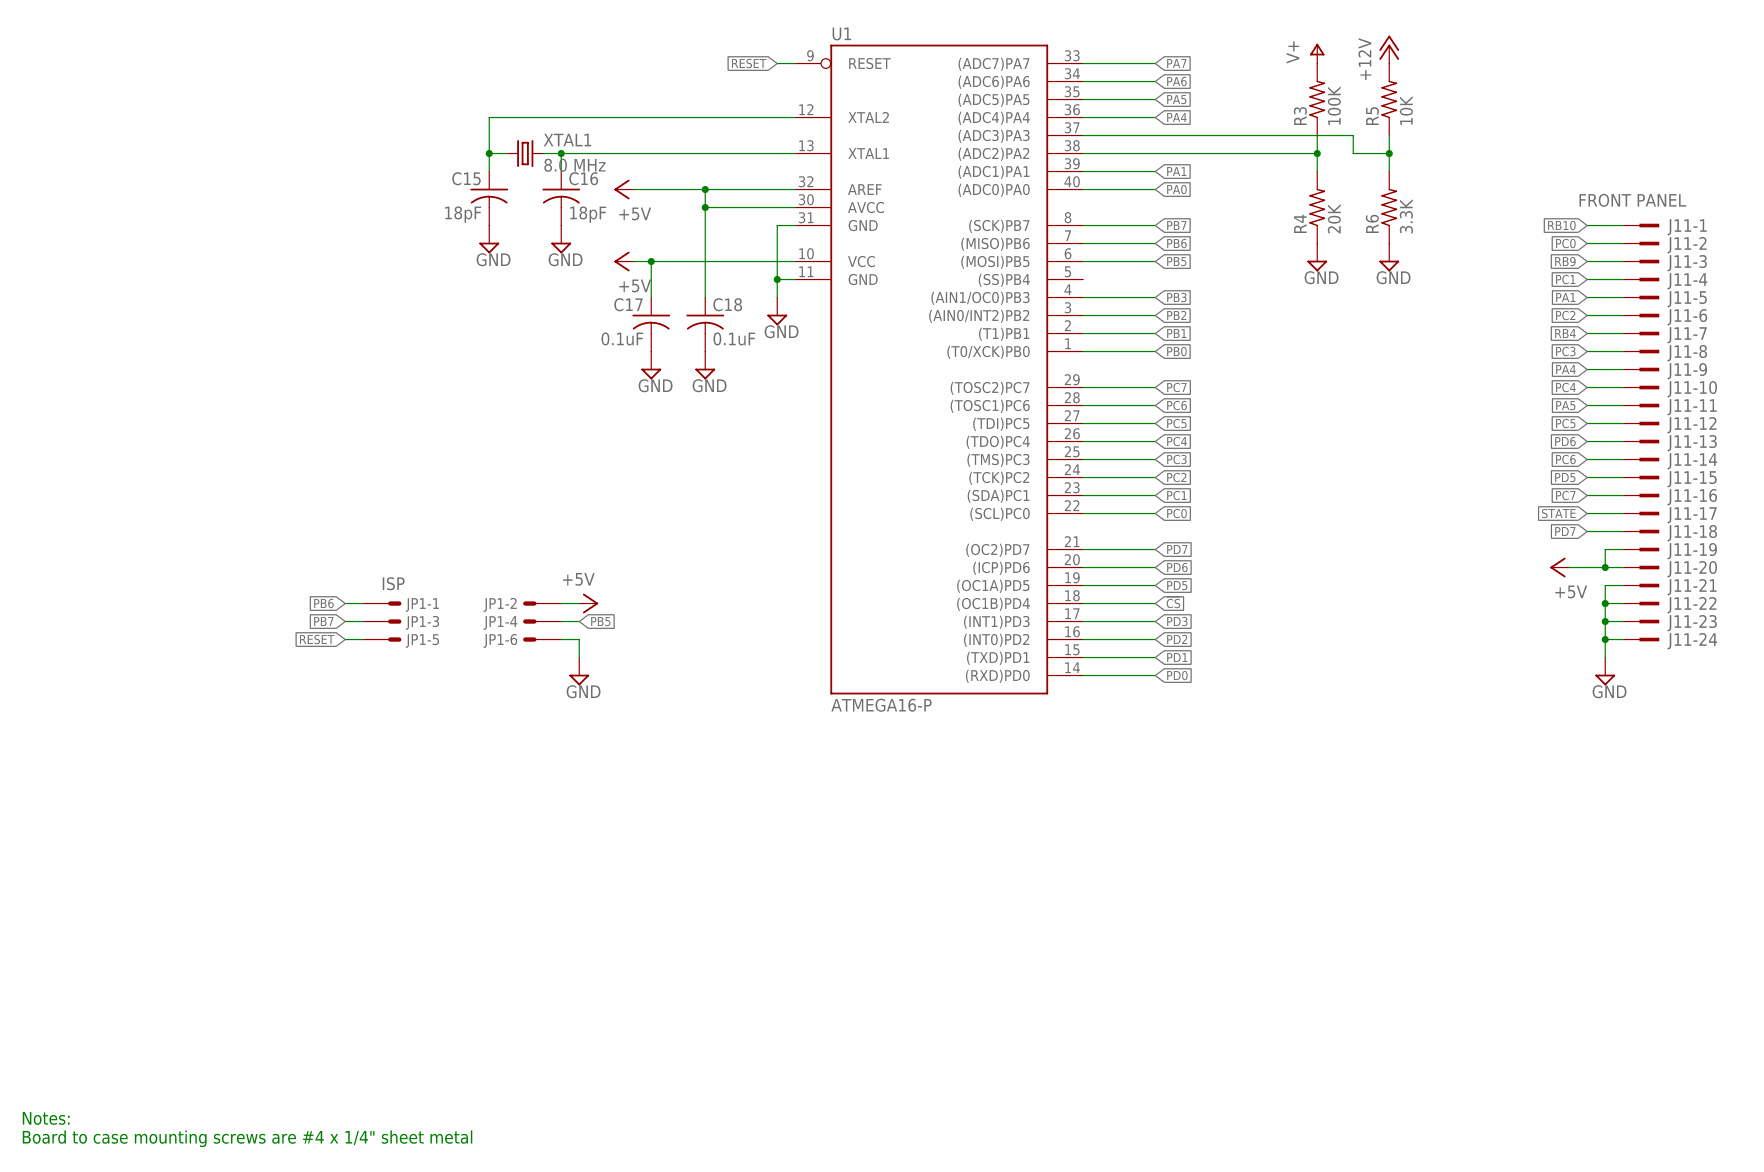
[picture p11: schematic MK-312BT V1.2.sch, sheet 2]

Parts:
C15, C16: 18pF; C025-024X044
C17, C18: 0.1uF; C025-024X044
J11: FRONT PANEL; PAK100/2500-24
JP1: ISP; 057-006-1
R3: 100K; 0207/10
R4: 20K; 0207/10
R5: 10K; 0207/10
R6: 3.3K; 0207/10
U1: ATMEGA16-P; DIL40
XTAL1: 8.0 MHz; HC49/S

Connections:
!CS: U1.18 ((OC1B)PD4); also elsewhere on the board
+5V: C17.1, C18.1, J11.19, J11.20, JP1.2, U1.10 (VCC), U1.30 (AVCC), U1.32 (AREF); also elsewhere on the board
+12V: R5.2; also elsewhere on the board
GND: C15.2, C16.2, C17.2, C18.2, J11.21, J11.22, J11.23, J11.24, JP1.6, R4.1, R6.1, U1.11 (GND), U1.31 (GND); also elsewhere on the board
unnamed: R5.1, R6.2, U1.37 ((ADC3)PA3)
unnamed: R3.1, R4.2, U1.38 ((ADC2)PA2)
unnamed: C16.1, U1.13 (XTAL1), XTAL1.2
unnamed: C15.1, U1.12 (XTAL2), XTAL1.1
PA0: U1.40 ((ADC0)PA0); also elsewhere on the board
PA1: J11.5, U1.39 ((ADC1)PA1); also elsewhere on the board
PA4: J11.9, U1.36 ((ADC4)PA4)
PA5: J11.11, U1.35 ((ADC5)PA5)
PA6: U1.34 ((ADC6)PA6); also elsewhere on the board
PA7: U1.33 ((ADC7)PA7); also elsewhere on the board
PB0: U1.1 ((T0/XCK)PB0); also elsewhere on the board
PB1: U1.2 ((T1)PB1); also elsewhere on the board
PB2: U1.3 ((AIN0/INT2)PB2); also elsewhere on the board
PB3: U1.4 ((AIN1/OC0)PB3); also elsewhere on the board
PB5: JP1.4, U1.6 ((MOSI)PB5); also elsewhere on the board
PB6: JP1.1, U1.7 ((MISO)PB6)
PB7: JP1.3, U1.8 ((SCK)PB7); also elsewhere on the board
PC0: J11.2, U1.22 ((SCL)PC0); also elsewhere on the board
PC1: J11.4, U1.23 ((SDA)PC1); also elsewhere on the board
PC2: J11.6, U1.24 ((TCK)PC2); also elsewhere on the board
PC3: J11.8, U1.25 ((TMS)PC3); also elsewhere on the board
PC4: J11.10, U1.26 ((TDO)PC4); also elsewhere on the board
PC5: J11.12, U1.27 ((TDI)PC5); also elsewhere on the board
PC6: J11.14, U1.28 ((TOSC1)PC6); also elsewhere on the board
PC7: J11.16, U1.29 ((TOSC2)PC7); also elsewhere on the board
PD0: U1.14 ((RXD)PD0); also elsewhere on the board
PD1: U1.15 ((TXD)PD1); also elsewhere on the board
PD2: U1.16 ((INT0)PD2); also elsewhere on the board
PD3: U1.17 ((INT1)PD3); also elsewhere on the board
PD5: J11.15, U1.19 ((OC1A)PD5); also elsewhere on the board
PD6: J11.13, U1.20 ((ICP)PD6); also elsewhere on the board
PD7: J11.18, U1.21 ((OC2)PD7); also elsewhere on the board
RB4: J11.7; also elsewhere on the board
RB9: J11.3; also elsewhere on the board
RB10: J11.1; also elsewhere on the board
RESET: JP1.5, U1.9 (RESET)
STATE: J11.17; also elsewhere on the board
V+: R3.2; also elsewhere on the board

Notes on the sheet:
Notes: Board to case mounting screws are #4 x 1/4" sheet metal

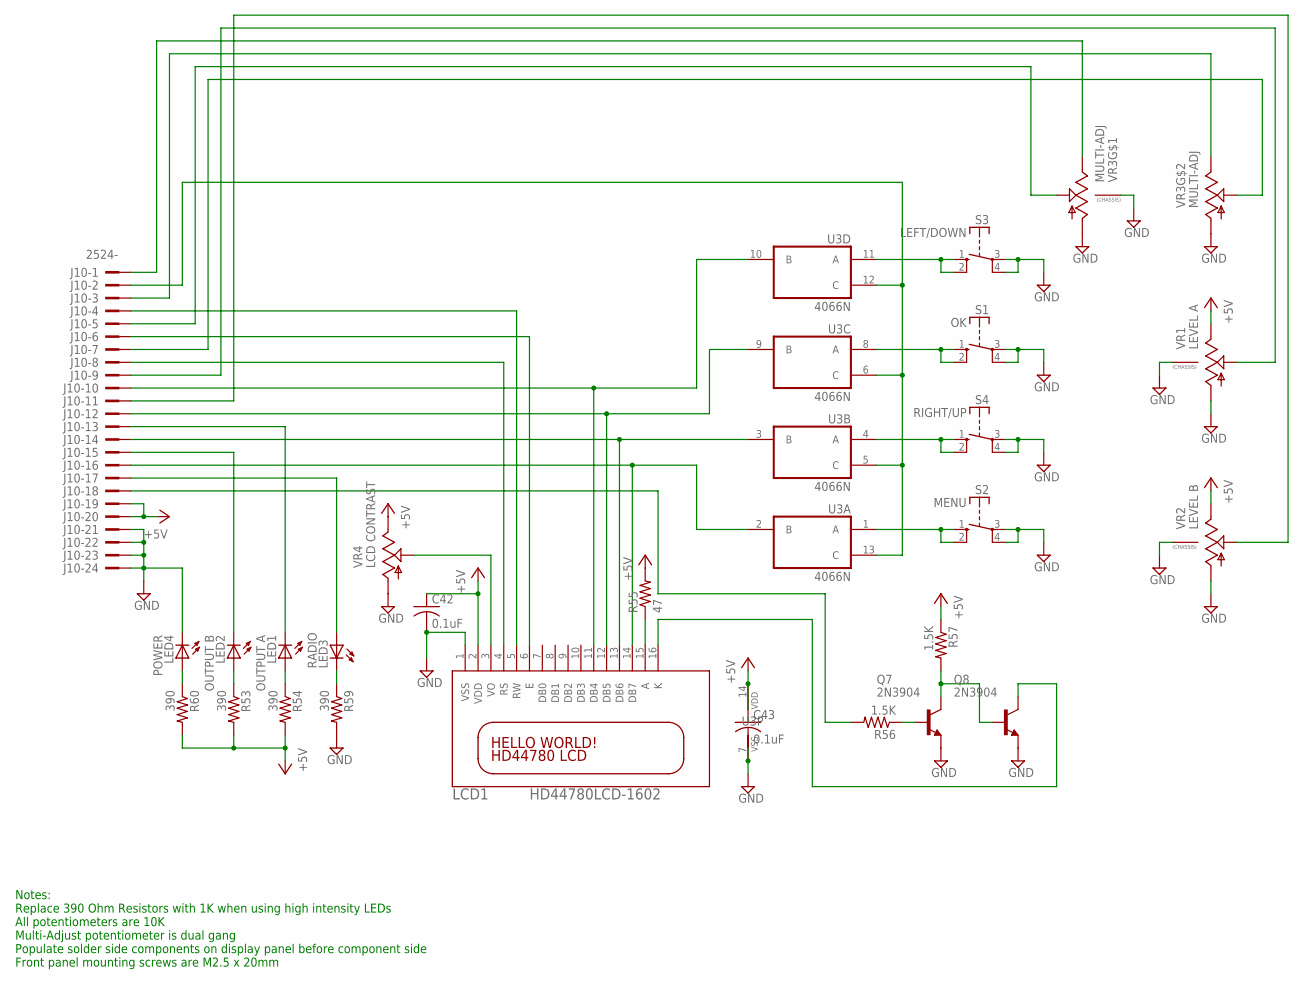
[picture p12: schematic MK-312BT V1.2.sch, sheet 3, Small PCB]

Parts:
C42, C43: 0.1uF; C025-024X044
J10: 2524-; PAK100/2500-24
LCD1: HD44780LCD-1602; LCD1602
LED1: OUTPUT A; LED5MM
LED2: OUTPUT B; LED5MM
LED3: RADIO; LED5MM
LED4: POWER; LED5MM
Q7, Q8: 2N3904; TO92
R53, R54, R59, R60: 390; 0207/10
R55: 47; 0207/10
R56, R57: 1.5K; 0207/10
S1: OK; DTE6K
S2: MENU; DTE6K
S3: LEFT/DOWN; DTE6K
S4: RIGHT/UP; DTE6K
U3: 4066N; DIL14
VR1: LEVEL A; 9MM_SNAP-IN_POT
VR2: LEVEL B; 9MM_SNAP-IN_POT
VR3: MULTI-ADJ; DUAL_9MM_SNAP-IN_POT
VR4: LCD CONTRAST; B25P

Connections:
+5V: C42.1, C43.1, J10.19, J10.20, LCD1.2 (VDD), R53.2, R54.2, R55.2, R57.1, R60.2, U3.14 (VDD), VR1.3 (E), VR2.3 (E), VR4.E; also elsewhere on the board
GND: C42.2, C43.2, J10.21, J10.22, J10.23, J10.24, LCD1.1 (VSS), LED4.K (C), Q7.3 (E), Q8.3 (E), R59.2, S1.3, S1.4, S2.3, S2.4, S3.3, S3.4, S4.3, S4.4, U3.7 (VSS), VR1.1 (A), VR1.CHASSIS2, VR2.1 (A), VR2.CHASSIS2, VR3.1 (A), VR3.1B (A), VR3.CHASSIS1, VR3.CHASSIS2, VR4.A; also elsewhere on the board
unnamed: J10.7, VR3.2B (S)
unnamed: S1.1 (S), S1.2 (S), U3.8 (A)
unnamed: S3.1 (S), S3.2 (S), U3.11 (A)
unnamed: S4.1 (S), S4.2 (S), U3.4 (A)
unnamed: J10.3, VR3.3B (E)
unnamed: J10.9, VR1.2 (S)
unnamed: J10.11, VR2.2 (S)
unnamed: J10.1, VR3.3 (E)
unnamed: J10.5, VR3.2 (S)
unnamed: LED2.A, R53.1
unnamed: LED1.A, R54.1
unnamed: LCD1.3 (VO), VR4.S
unnamed: LCD1.15 (A), R55.1
unnamed: LED3.K (C), R59.1
unnamed: S2.1 (S), S2.2 (S), U3.1 (A)
unnamed: LED4.A, R60.1
unnamed: Q7.2 (B), R56.1
unnamed: Q7.1 (C), Q8.2 (B), R57.2
unnamed: LCD1.16 (K), Q8.1 (C)
unnamed: J10.17, LED3.A
PC0: J10.2, U3.5 (C), U3.6 (C), U3.12 (C), U3.13 (C); also elsewhere on the board
PC1: J10.4, LCD1.5 (RW); also elsewhere on the board
PC2: J10.6, LCD1.6 (E); also elsewhere on the board
PC3: J10.8, LCD1.4 (RS); also elsewhere on the board
PC4: J10.10, LCD1.11 (DB4), U3.10 (B); also elsewhere on the board
PC5: J10.12, LCD1.12 (DB5), U3.9 (B); also elsewhere on the board
PC6: J10.14, LCD1.13 (DB6), U3.3 (B); also elsewhere on the board
PC7: J10.16, LCD1.14 (DB7), U3.2 (B); also elsewhere on the board
PD5: J10.15, LED2.K (C); also elsewhere on the board
PD6: J10.13, LED1.K (C); also elsewhere on the board
PD7: J10.18, R56.2; also elsewhere on the board

Notes on the sheet:
Notes: Replace 390 Ohm Resistors with 1K when using high intensity LEDs All potentiometers are 10K Multi-Adjust potentiometer is dual gang Populate solder side components on display panel before component side Front panel mounting screws are M2.5 x 20mm

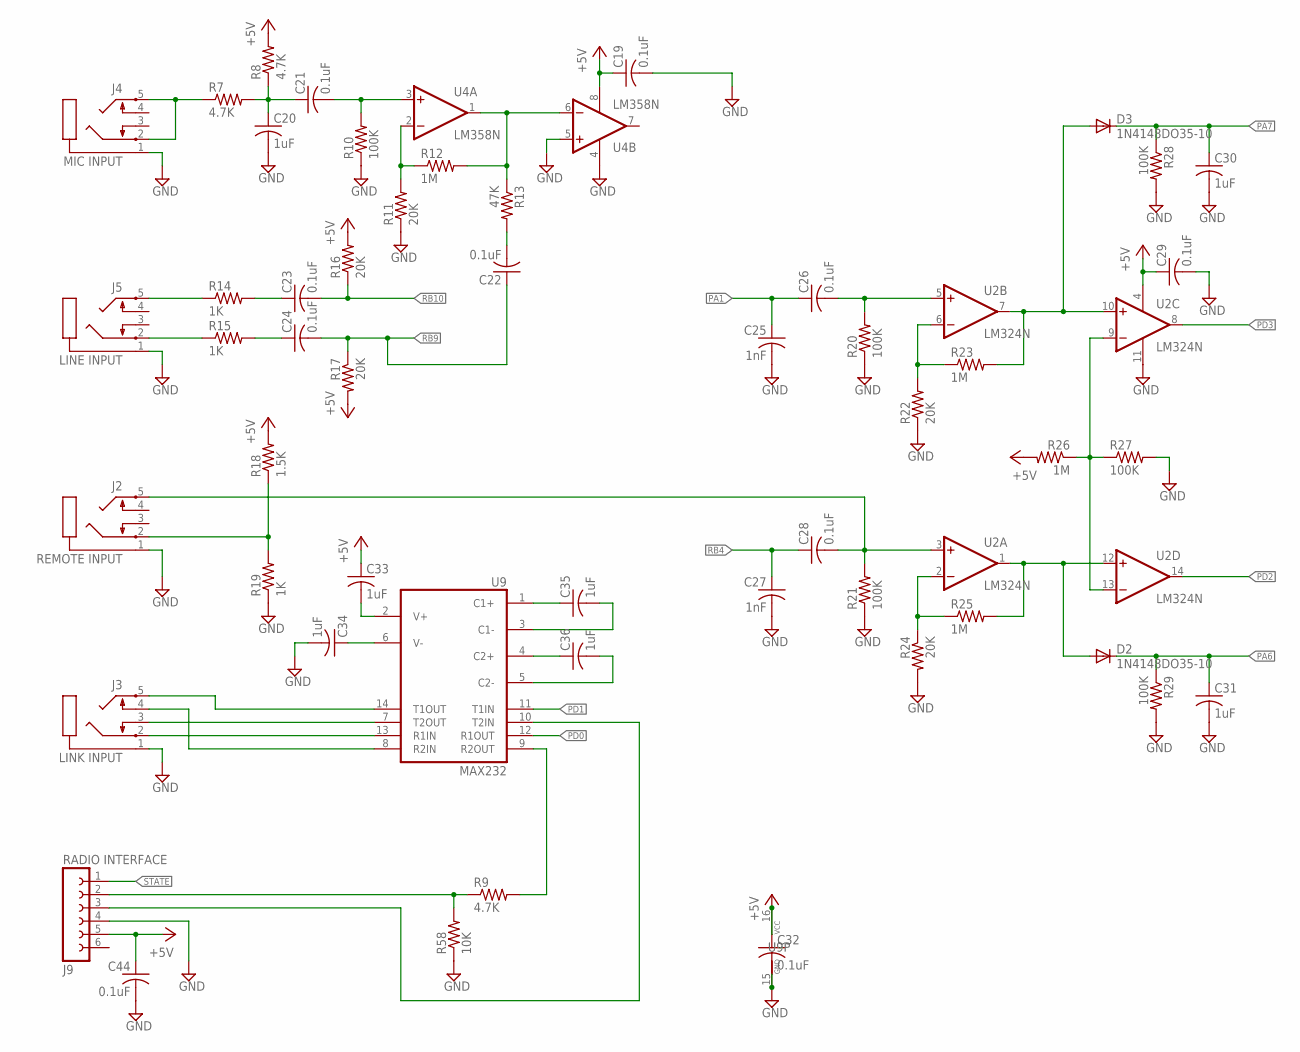
[picture p13: schematic MK-312BT V1.2.sch, sheet 4, Input stage]

Parts:
C19, C21, C22, C23, C24, C26, C28, C29, C32, C44: 0.1uF; C025-024X044
C20, C30, C31, C33, C34, C35, C36: 1uF; C025-024X044
C25, C27: 1nF; C025-024X044
D2, D3: 1N4148DO35-10; DO35-10
J2: REMOTE INPUT; STX3100
J3: LINK INPUT; STX3100
J4: MIC INPUT; STX3100
J5: LINE INPUT; STX3100
J9: RADIO INTERFACE; FE06
R7, R8, R9: 4.7K; 0207/10
R10, R20, R21, R27, R28, R29: 100K; 0207/10
R11, R16, R17, R22, R24: 20K; 0207/10
R12, R23, R25, R26: 1M; 0207/10
R13: 47K; 0207/10
R14, R15, R19: 1K; 0207/10
R18: 1.5K; 0207/10
R58: 10K; 0207/10
U2: LM324N; DIL14
U4: LM358N; DIL08
U9: MAX232; DIL16

Connections:
+5V: C19.1, C29.1, C32.1, C33.1, C44.1, J9.5, R8.2, R16.2, R17.2, R18.2, R26.2, U2.4 (V+), U4.8 (V+), U9.16 (VCC); also elsewhere on the board
GND: C19.2, C20.2, C25.2, C27.2, C29.2, C30.2, C31.2, C32.2, C34.2, C44.2, J2.1, J3.1, J4.1, J5.1, J9.4, R10.1, R11.1, R19.1, R20.1, R21.1, R22.1, R24.2, R27.2, R28.2, R29.2, R58.1, U2.11 (V-), U4.4 (V-), U4.5 (+IN), U9.15 (GND); also elsewhere on the board
unnamed: C28.2, J2.5, R21.2, U2.3 (+IN)
unnamed: R9.2, U9.9 (R2OUT)
unnamed: J3.5, U9.14 (T1OUT)
unnamed: J3.2, U9.13 (R1IN)
unnamed: C35.1, U9.1 (C1+)
unnamed: R24.1, R25.1, U2.2 (-IN)
unnamed: D2.A, R25.2, U2.1 (OUT), U2.12 (+IN)
unnamed: J5.2, R15.1
unnamed: J5.5, R14.1
unnamed: C23.1, R14.2
unnamed: J2.2, R18.1, R19.2
unnamed: R22.2, R23.1, U2.6 (-IN)
unnamed: C35.2, U9.3 (C1-)
unnamed: R26.1, R27.1, U2.9 (-IN), U2.13 (-IN)
unnamed: C26.2, R20.2, U2.5 (+IN)
unnamed: C24.1, R15.2
unnamed: C36.2, U9.5 (C2-)
unnamed: C36.1, U9.4 (C2+)
unnamed: J9.2, R9.1, R58.2
unnamed: D3.A, R23.2, U2.7 (OUT), U2.10 (+IN)
unnamed: C34.1, U9.6 (V-)
unnamed: J4.2, J4.5, R7.1
unnamed: C20.1, C21.1, R7.2, R8.1
unnamed: C21.2, R10.2, U4.3 (+IN)
unnamed: R11.2, R12.1, U4.2 (-IN)
unnamed: R12.2, R13.1, U4.1 (OUT), U4.6 (-IN)
unnamed: C22.2, R13.2
unnamed: C33.2, U9.2 (V+)
unnamed: J3.4, U9.8 (R2IN)
unnamed: J3.3, U9.7 (T2OUT)
unnamed: J9.3, U9.10 (T2IN)
PA1: C25.1, C26.1; also elsewhere on the board
PA6: C31.1, D2.C, R29.1; also elsewhere on the board
PA7: C30.1, D3.C, R28.1; also elsewhere on the board
PD0: U9.12 (R1OUT); also elsewhere on the board
PD1: U9.11 (T1IN); also elsewhere on the board
PD2: U2.14 (OUT); also elsewhere on the board
PD3: U2.8 (OUT); also elsewhere on the board
RB4: C27.1, C28.1; also elsewhere on the board
RB9: C22.1, C24.2, R17.1; also elsewhere on the board
RB10: C23.2, R16.1; also elsewhere on the board
STATE: J9.1; also elsewhere on the board

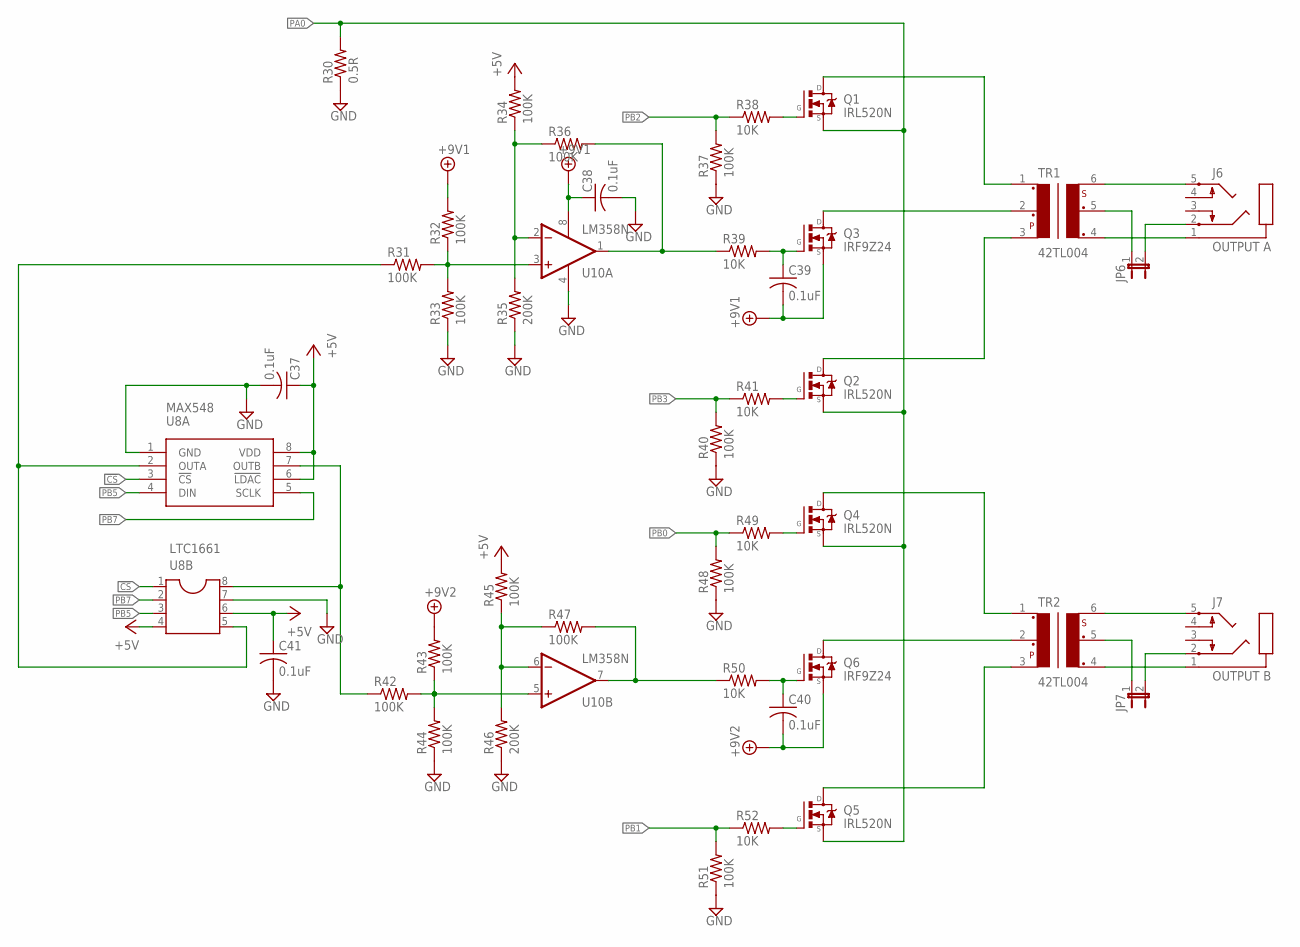
[picture p14: schematic MK-312BT V1.2.sch, sheet 5, Output stage]

Parts:
C37, C38, C39, C40, C41: 0.1uF; C025-024X044
J6: OUTPUT A; STX3100
J7: OUTPUT B; STX3100
JP6, JP7: JP1E; JP1
Q1, Q2, Q4, Q5: IRL520N; TO220V
Q3, Q6: IRF9Z24; TO220V
R30: 0.5R; 0309/12
R31, R32, R33, R34, R36, R37, R40, R42, R43, R44, R45, R47, R48, R51: 100K; 0207/10
R35, R46: 200K; 0207/10
R38, R39, R41, R49, R50, R52: 10K; 0207/10
TR1, TR2: 42TL004; 42TL
U8A: MAX548; DIL08
U8B: LTC1661; SOCKET-08
U10: LM358N; DIL08

Connections:
!CS: U8A.3 (!CS), U8B.1; also elsewhere on the board
+5V: C37.1, C41.1, R34.2, R45.2, U8A.6 (!LDAC), U8A.8 (VDD), U8B.4, U8B.6; also elsewhere on the board
+8V: C38.1, C39.2, Q3.3 (S), R32.2, U10.8 (V+); also elsewhere on the board
+9V: C40.2, Q6.3 (S), R43.2; also elsewhere on the board
GND: C37.2, C38.2, C41.2, R30.1, R33.1, R35.1, R37.1, R40.1, R44.1, R46.1, R48.1, R51.1, U8A.1 (GND), U8B.7, U10.4 (V-); also elsewhere on the board
unnamed: J6.1, TR1.4
unnamed: JP7.1, TR2.5
unnamed: J6.5, TR1.6
unnamed: Q1.1 (G), R38.2
unnamed: Q2.1 (G), R41.2
unnamed: J7.2, JP7.2
unnamed: C39.1, Q3.1 (G), R39.2
unnamed: R31.2, R32.1, R33.2, U10.3 (+IN)
unnamed: Q4.1 (G), R49.2
unnamed: Q5.1 (G), R52.2
unnamed: C40.1, Q6.1 (G), R50.2
unnamed: R42.2, R43.1, R44.2, U10.5 (+IN)
unnamed: Q1.2 (D), TR1.1
unnamed: Q3.2 (D), TR1.2
unnamed: Q4.2 (D), TR2.1
unnamed: Q6.2 (D), TR2.2
unnamed: Q5.2 (D), TR2.3
unnamed: Q2.2 (D), TR1.3
unnamed: R34.1, R35.2, R36.1, U10.2 (-IN)
unnamed: R45.1, R46.2, R47.1, U10.6 (-IN)
unnamed: R31.1, U8A.2 (OUTA), U8B.5
unnamed: J6.2, JP6.2
unnamed: J7.5, TR2.6
unnamed: J7.1, TR2.4
unnamed: JP6.1, TR1.5
unnamed: R42.1, U8A.7 (OUTB), U8B.8
PA0: Q1.3 (S), Q2.3 (S), Q4.3 (S), Q5.3 (S), R30.2; also elsewhere on the board
PB0: R48.2, R49.1; also elsewhere on the board
PB1: R51.2, R52.1; also elsewhere on the board
PB2: R37.2, R38.1; also elsewhere on the board
PB3: R40.2, R41.1; also elsewhere on the board
PB5: U8A.4 (DIN), U8B.3; also elsewhere on the board
PB7: U8A.5 (SCLK), U8B.2; also elsewhere on the board
PFET_A: R36.2, R39.1, U10.1 (OUT)
PFET_B: R47.2, R50.1, U10.7 (OUT)

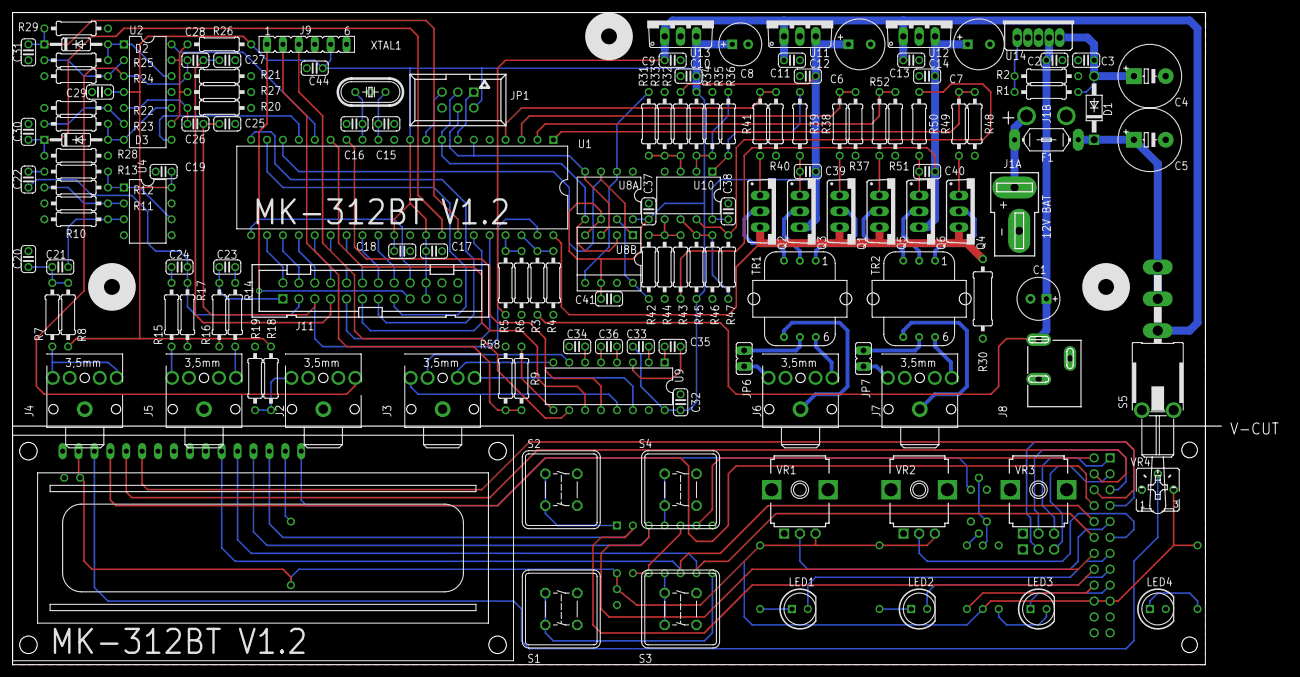
[picture p15: board MK-312BT V1.2.brd from above]

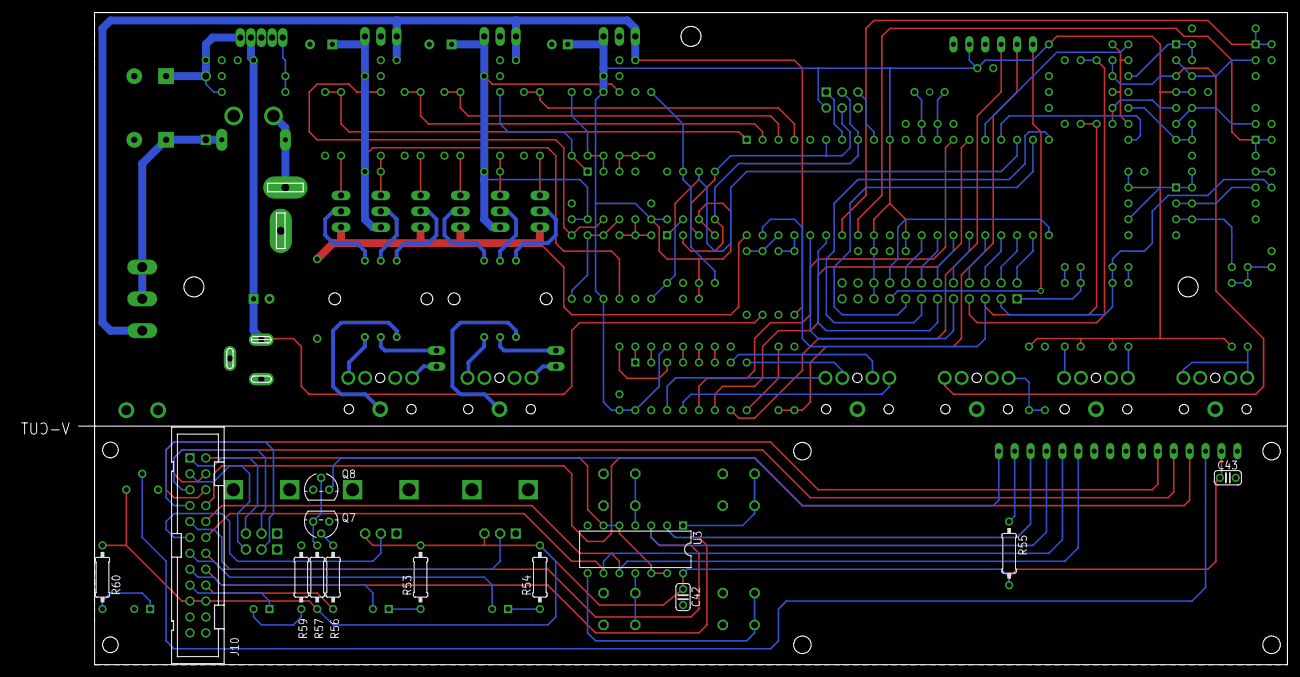
[picture p16: board MK-312BT V1.2.brd from below]

Board: 2 copper layers, 193.0 x 104.1 mm, 159 parts (13 on the bottom side), 127 nets.
