controlprogram/mk312-bt/(commit log)

2017-02-11 Initial commit, v1.2 of mk312-bt board
    [MK-312BT Front Panel V1.2.brd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]
2017-02-23 Added v1.2 updates, pictures, bluetooth config tool/docs
    [MK-312BT.ods, MK-312BT.xlsx, MK-312BTMOUSERBOMIMPORT.csv]
2017-06-04 Rename directories to make windows happy
    Fixes #2
    [MK-312BT Front Panel V1.2.brd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]
