controlprogram/mk312-bt/(notices)

Notices in the files:
parts and their libraries:
SparkFun-Connectors: Licensing: Creative Commons ShareAlike 4.0 International - https://creativecommons.org/licenses/by-sa/4.0
national-semi: Copyright (C) 2008, Bob Starr
